zolotarev88/DI_sil3-4/Схема.docx

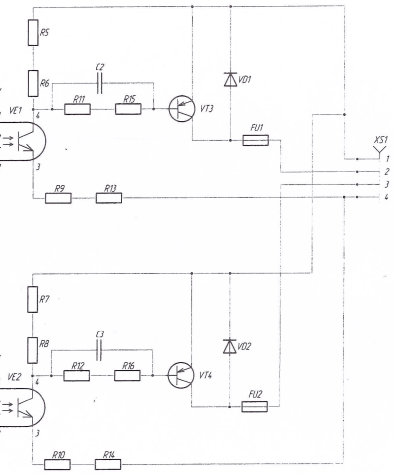
[picture p35: figure]
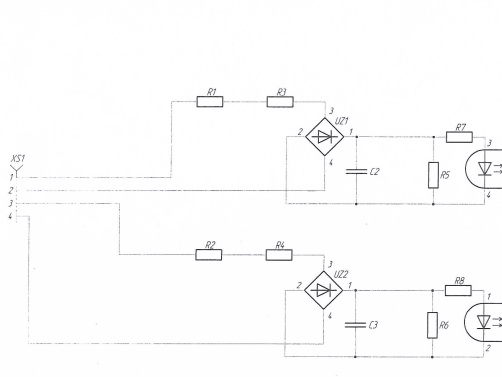
[picture p36: figure]
