zolotarev88/DI_sil3-4/Стр. МВВ.pdf

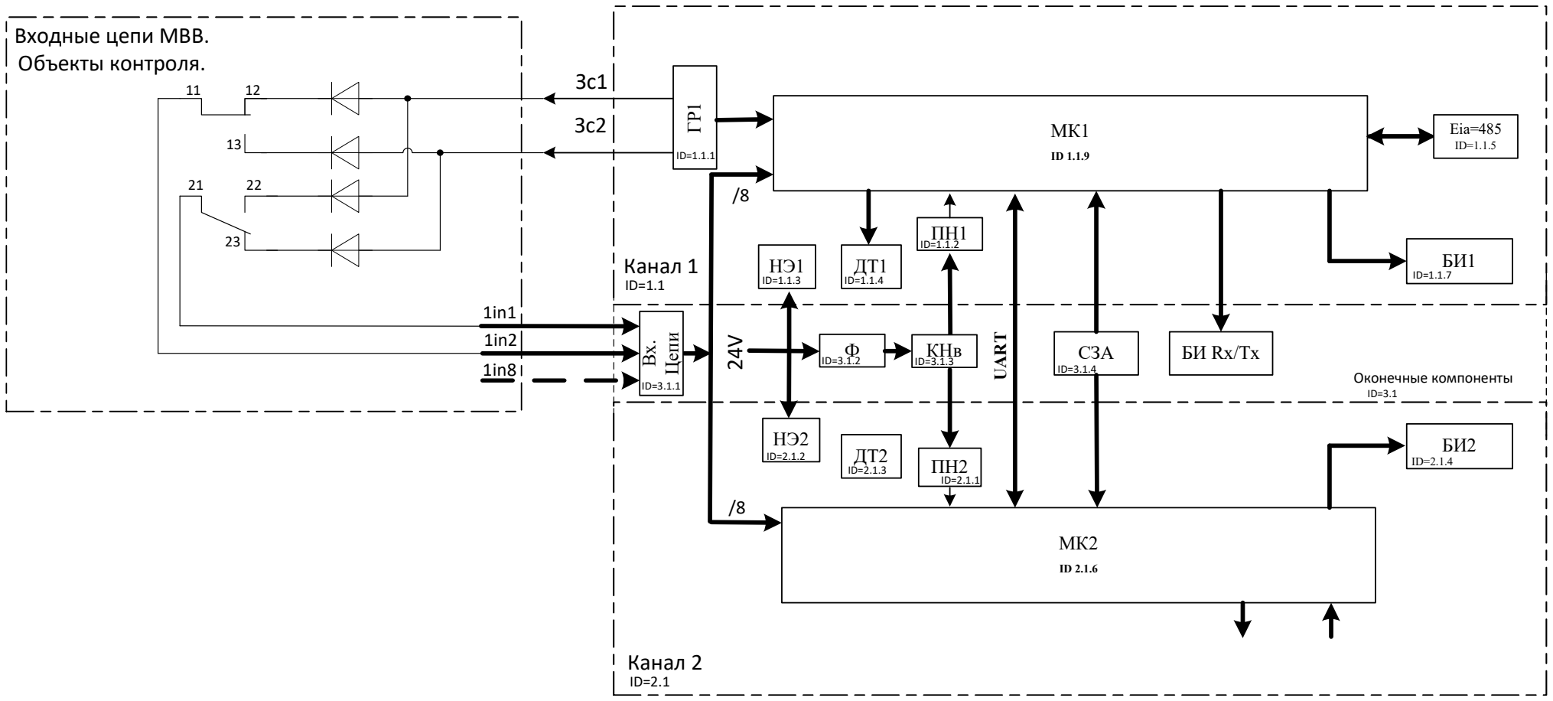
[picture p37: figure]
МК1 ID 1.1.9 UART; Входные цепи МВВ. Объекты контроля.; Канал 1; Канал 2; 22 Вх. Цепи; БИ1 ГР¹; Eia=485 ID=1.1.5; Оконечные компоненты; КНв; СЗА ID=3.1.4

НЭ1, НЭ2 - нагревательный элемент;
ДТ1, ДТ2 – датчик температуры;
ГР1 – гальваническая развязка внутренних цепей;
ГР –гальваническая развязка входных цепей;
Зс1, Зс2 – зондирующие сигналы;
(Импульсы поступают апериодически, но не реже чем 1 раз в 10 мс.)
Модуль воспринимает импульсы, формирует ответный пакет, и при поступление запроса от головного устройства, передает пакет.
ПН1 (ПН2) – преобразователь напряжения, предназначенный для электропитания МК1 (МК2), содержит элементы обеспечивающие гальваническую развязку внешних и внутренних цепей МВ;
ИВ1 – индикатор работы интерфейса RS-485 первого (второго) канала МВ в режиме приема данных;
ИИ1 – индикаторная пара работы порта RS-485 прием/передача;
Ф - Синфазный фильтр питания;
КНв – Контроль напряжения;
СЗА – Схема задания адресса;

### Рисунок Б.1 – Функциональная схема МВВ ЕРКФ.426436.001

Гр.1

ID 1.1.1

ПН1

ID 1.1.2

МК1

ID 1.1.9

НЭ1

ID 1.1.3

ДТ1

ID 1.1.4

EIA-485

ID 1.1.5

ПН2

ID 2.1.1

МК1

ID 2.1.6

НЭ1

ID 2.1.3

ДТ1

ID 2.1.4

Гр

ID 3.1.1

Ф

ID 3.1.2

КНв

ID 3.1.3

СЗА

ID 3.1.4

Канал 1.

## Канал 2

## Оконечные компоненты

Кан. 1 | Кан. 2 | Окон. Комп.

Общая.
