zolotarev88/DI_sil3-4/npcprom/WhatsApp Image 2022-07-06 at 10.55.22.jpeg

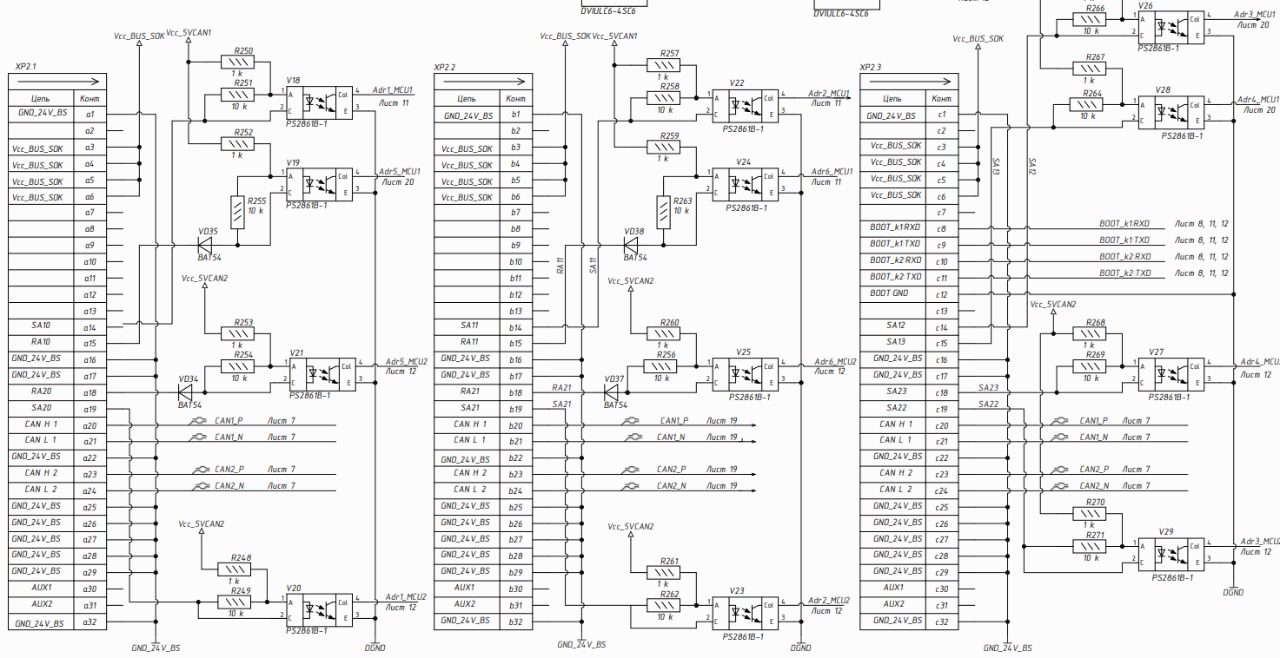
npcprom/WhatsApp Image 2022-07-06 at 10.55.22.jpeg
