zolotarev88/DI_sil3-4/npcprom/DI_перечень.xlsx

позиционное обозначение | номинал | Kommentar
C1 — С9 | 1000 пФ | CC0603KRX7R9BB102, Керамический ЧИП-конденсатор 0603 X7R 1000пФ ±10% 50В
C10 | 10 мкФ | CC1210KKX7R9BB106, Керамический ЧИП-конденсатор 1210 X7R 10мкФ ±10% 50В
C11 | 470 мкФ | SH063M0470B5S-1325, Конденсатор радиальный миниатюрный 470мкФ 63В ±20% 13*25 105°
C12 | 1 мкФ | CC0603KRX7R9BB105, Керамический ЧИП-конденсатор 0603 X7R 1мкФ ±10% 50В
C13 | 10 мкФ | CC1210KKX7R9BB106, Керамический ЧИП-конденсатор 1210 X7R 10мкФ ±10% 50В
C14, C15 | 1 нФ 2000v | CC1206KKX7RDBB102, Керамический ЧИП-конденсатор 1206 X7R 1000пФ ±10% 2000В
C16, C17 | 10 мкФ | CC1210KKX7R9BB106, Керамический ЧИП-конденсатор 1210 X7R 10мкФ ±10% 50В
C18 | 1 мкФ | CC0603KRX7R9BB105, Керамический ЧИП-конденсатор 0603 X7R 1мкФ ±10% 50В
C19, C20 | 0,1 мкФ | CC0603KRX5R9BB104, Керамический ЧИП-конденсатор 0603 X5R 0.1мкФ ±10% 50В
C21 | 1 мкФ | CC0603KRX7R9BB105, Керамический ЧИП-конденсатор 0603 X7R 1мкФ ±10% 50В
C22 | 1 нФ 2000v | CC1206KKX7RDBB102, Керамический ЧИП-конденсатор 1206 X7R 1000пФ ±10% 2000В
C23 - С25 | 0,1 мкФ | CC0603KRX5R9BB104, Керамический ЧИП-конденсатор 0603 X5R 0.1мкФ ±10% 50В
C26б C27 | 22 мкФ | CC1206KKX7R6BB226, Керамический ЧИП-конденсатор 1206 X7R 22мкФ ±10% 10В
C28 | 0,1 мкФ | CC0603KRX5R9BB104, Керамический ЧИП-конденсатор 0603 X5R 0.1мкФ ±10% 50В
C29 | 12 пФ | C0603FRNPO9BN120, Керамический ЧИП-конденсатор 0603 NP0 12пФ ±1% 50В
C30 | 0,1 мкФ | CC0603KRX5R9BB104, Керамический ЧИП-конденсатор 0603 X5R 0.1мкФ ±10% 50В
C31 | 12 пФ | C0603FRNPO9BN120, Керамический ЧИП-конденсатор 0603 NP0 12пФ ±1% 50В
C32, C33 | 0,1 мкФ | CC0603KRX5R9BB104, Керамический ЧИП-конденсатор 0603 X5R 0.1мкФ ±10% 50В
C34, C35 | 22 мкФ | CC1206KKX7R6BB226, Керамический ЧИП-конденсатор 1206 X7R 22мкФ ±10% 10В
C36 | 0,1 мкФ | CC0603KRX5R9BB104, Керамический ЧИП-конденсатор 0603 X5R 0.1мкФ ±10% 50В
C37 | 12 пФ | C0603FRNPO9BN120, Керамический ЧИП-конденсатор 0603 NP0 12пФ ±1% 50В
C38 | 0,1 мкФ | CC0603KRX5R9BB104, Керамический ЧИП-конденсатор 0603 X5R 0.1мкФ ±10% 50В
C39 | 12 пФ | C0603FRNPO9BN120, Керамический ЧИП-конденсатор 0603 NP0 12пФ ±1% 50В
C40, C41 | 0,1 мкФ | CC0603KRX5R9BB104, Керамический ЧИП-конденсатор 0603 X5R 0.1мкФ ±10% 50В
D1, D2 | STM32F103CBT6 | микроконтроллер (аналоги GD32F103CBT6, FCM32F103CBT6, APM32F103CBT6, HK32F103CBT6, RX32F103CBT7-CBT6)
DA1, DA2 | F2405S-2WR3 | 2W isolated DC-DC converter
DA3 | TD541S485H | rs-485 driver
DA4, DA5 | AMS1117-3.3 | линейный стабилизатор напряжения
DD1- DD3 | 74HC595PW,118 | сдвиговый регистр 8 бит
FU1, FU2 | 0466.125NR | 0466.125NR, FF Fuse Chip Very Fast Acting 0.125A 125V SMD
FU3 — FU5 | 60R090XPR | 60R090XPR, Самовосстанавливающийся предохранитель PTC 0.9A(hold) 1.8A(trip) 60VDC 40A 0.99W 7.2s 0.2Ohm Radial 11.2 X 3.1mm
HL1 — HL20 | LTST-C191KGKT | Светодиод smd 1,6х0,8мм/зеленый/571нм/18-71мкд/прозрачный/130°
L1, L2 | 1 мкГн | B82498B1102J, ЧИП-индуктивность на керамике 0805 1.0мкГн ±5% 250мА
L3 | B82790S0513N201 | Дроссель на тороидальном ферритовом сердечнике с секторной обмоткой для подавления асимметричной и симметричной интерференций 51uH 0.5A SMD
L4 | 22u | CDR74BNP-220MC, Силовая SMD индуктивность 22uH ±20% 1.12A 0.13Om c магнитным экраном
L5 | ACM2520-301-2P-T002 | Синфазные дроссели / фильтры 300ohms 0.35ohms 0.4A
L6, L7 | 10 мкГн | LQM18FN100M00D, Многослойнная индуктивность SMD на ферритовом сердечнике 1МГц 10мкГн ±20% 50мА 1,17Ом по постоянному току
R1 - R4 | 10 кОм | RC1206JR-0710KL, Толстопленочный ЧИП-резистор 1206 10кОм ±5% 0.25Вт -55°С...+155°С
R5 — R8 | 2 кОм | RC0603JR-072KL, Толстопленочный ЧИП-резистор 0603 2кОм ±5% 0.1Вт -55°С...+155°С
R9 — R12 | 100 кОм | RC0603JR-07100KL, Толстопленочный ЧИП-резистор 0603 100кОм ±5% 0.1Вт -55°С...+155°С
R13 — R16 | 10 кОм | RC1206JR-0710KL, Толстопленочный ЧИП-резистор 1206 10кОм ±5% 0.25Вт -55°С...+155°С
R17 — R20 | 2 кОм | RC0603JR-072KL, Толстопленочный ЧИП-резистор 0603 2кОм ±5% 0.1Вт -55°С...+155°С
R21 — R24 | 100 кОм | RC0603JR-07100KL, Толстопленочный ЧИП-резистор 0603 100кОм ±5% 0.1Вт -55°С...+155°С
R25, R26 | 330 Ом | RC0603JR-07330RL, Толстопленочный ЧИП-резистор 0603 330Ом ±5% 0.1Вт -55°С...+155°С
R27, R28 | 10 кОм | RC1206JR-0710KL, Толстопленочный ЧИП-резистор 1206 10кОм ±5% 0.25Вт -55°С...+155°С
R29, R30 | 100 кОм | RC0603JR-07100KL, Толстопленочный ЧИП-резистор 0603 100кОм ±5% 0.1Вт -55°С...+155°С
R31, 32 | 330 Ом | RC0603JR-07330RL, Толстопленочный ЧИП-резистор 0603 330Ом ±5% 0.1Вт -55°С...+155°С
R33, R34 | 2 кОм | RC1206JR-072KL, Толстопленочный ЧИП-резистор 1206 2кОм ±5% 0.25Вт -55°С...+155°С
R35, R36 | 100 кОм | RC0603JR-07100KL, Толстопленочный ЧИП-резистор 0603 100кОм ±5% 0.1Вт -55°С...+155°С
R37 | 8.2 кОм | RC0603JR-078K2L, Толстопленочный ЧИП-резистор 0603 8.2кОм ±5% 0.1Вт -55°С...+155°С
R38 — R40 | 10 кОм | RC1206JR-0710KL, Толстопленочный ЧИП-резистор 1206 10кОм ±5% 0.25Вт -55°С...+155°С
R41 | 100 кОм | RC0603JR-07100KL, Толстопленочный ЧИП-резистор 0603 100кОм ±5% 0.1Вт -55°С...+155°С
R42 | 10 кОм | RC1206JR-0710KL, Толстопленочный ЧИП-резистор 1206 10кОм ±5% 0.25Вт -55°С...+155°С
R43 | 100 кОм | RC0603JR-07100KL, Толстопленочный ЧИП-резистор 0603 100кОм ±5% 0.1Вт -55°С...+155°С
R44 | 8.2 кОм | RC0603JR-078K2L, Толстопленочный ЧИП-резистор 0603 8.2кОм ±5% 0.1Вт -55°С...+155°С
R45 | 330 Ом | RC0603JR-07330RL, Толстопленочный ЧИП-резистор 0603 330Ом ±5% 0.1Вт -55°С...+155°С
R46 — R47 | 100 кОм | RC0603JR-07100KL, Толстопленочный ЧИП-резистор 0603 100кОм ±5% 0.1Вт -55°С...+155°С
R48 | 10 кОм | RC1206JR-0710KL, Толстопленочный ЧИП-резистор 1206 10кОм ±5% 0.25Вт -55°С...+155°С
R49 | 15k | RC0603JR-0715KL, Толстопленочный ЧИП-резистор 0603 15кОм ±5% 0.1Вт -55°С...+155°С
R50 | 10 кОм | RC1206JR-0710KL, Толстопленочный ЧИП-резистор 1206 10кОм ±5% 0.25Вт -55°С...+155°С
R51 | 4,7 Ом | RC1206JR-074R7L, Толстопленочный ЧИП-резистор 1206 4.7Ом ±5% 0.25Вт -55°С...+155°С
R52 | 100 кОм | RC0603JR-07100KL, Толстопленочный ЧИП-резистор 0603 100кОм ±5% 0.1Вт -55°С...+155°С
R53 | 330 Ом | RC0603JR-07330RL, Толстопленочный ЧИП-резистор 0603 330Ом ±5% 0.1Вт -55°С...+155°С
R54 | 100 кОм | RC0603JR-07100KL, Толстопленочный ЧИП-резистор 0603 100кОм ±5% 0.1Вт -55°С...+155°С
R55 | 10 кОм | RC1206JR-0710KL, Толстопленочный ЧИП-резистор 1206 10кОм ±5% 0.25Вт -55°С...+155°С
R56 | 4,7 Ом | RC1206JR-074R7L, Толстопленочный ЧИП-резистор 1206 4.7Ом ±5% 0.25Вт -55°С...+155°С
R57 | 1 МОм | RC1206JR-071ML, Толстопленочный ЧИП-резистор 1206 1МОм ±5% 0.25Вт -55°С...+155°С
R58 | 5,1 Ом | RC0805JR-075R1L, Толстопленочный ЧИП-резистор 0805 5.1Ом ±5% 0.125Вт -55°С...+155°С
R60 — R79 | 330 Ом | RC0603JR-07330RL, Толстопленочный ЧИП-резистор 0603 330Ом ±5% 0.1Вт -55°С...+155°С
R80, R81 | 100 кОм | RC0603JR-07100KL, Толстопленочный ЧИП-резистор 0603 100кОм ±5% 0.1Вт -55°С...+155°С
U1 — U18 | LTV-356T-B | LTV-356T-B, Оптопара транзисторная одноканальная 3.75кВ /80В 0.05A Кус=130...260% 0.17Вт -30...+110°C
VD1 — VD14 | BAS70J | Диод Шоттки 70В 50мА
VD15, VD16 | PESD24VS1UB,115 | TVS диод защитный 24В_пиковое_рабочее 70В_ограничение SOD523
VD17, VD18 | BAS70J | Диод Шоттки 70В 50мА
VD19 | 10BQ100 | 10BQ100, Диод Шоттки 100В 1А
VD20 | s20k30 | B72220S1300K102, Варистор 30Vac/34Vdc, 2000A, 22V(1mA), радиальные выводы, россыпь, автомобильная серия
VD21, VD22 | TL431 | TL431QDBZR,215, Стабилизатор напряжения линейный регулируемый +2,495...+36В 0.1A ±2% -40...+125°C Rвых=0,2Ом
VD23 | 10BQ100 | 10BQ100, Диод Шоттки 100В 1А
VD24 | s20k30 | B72220S1300K102, Варистор 30Vac/34Vdc, 2000A, 22V(1mA), радиальные выводы, россыпь, автомобильная серия
VD25 | TL431 | TL431QDBZR,215, Стабилизатор напряжения линейный регулируемый +2,495...+36В 0.1A ±2% -40...+125°C Rвых=0,2Ом
VD26 | 10BQ100 | 10BQ100, Диод Шоттки 100В 1А
VD27 | s20k30 | B72220S1300K102, Варистор 30Vac/34Vdc, 2000A, 22V(1mA), радиальные выводы, россыпь, автомобильная серия
VD28 | BAS70J | Диод Шоттки 70В 50мА
VD29 | SMBJ8.5CA | SMBJ8.5CA-TR, Ограничитель напряжения Р=600Вт U=8.5В двунаправленный
VD30 | BAS70J | Диод Шоттки 70В 50мА
VT1, VT2 | BCX56,115 | Биполярный транзистор, NPN, 80 В, 1 А, 1.25 Вт
VT3 | 2n7002 | 2N7002K, Транзистор полевой N-канальный 60В 200мА, 0.2Вт
VT4 | IRFL9110TRPBF | IRFL9110TRPBF, Транзистор полевой P-канальный 100В 1.1А 3.1Вт
VT5 | BC846 | BC846BLT1G, Биполярный транзистор, NPN, 65 В, 0.1 А, 0.225 Вт
VT6 | MJD112G | MJD112G, Биполярный транзистор, NPN, составной (Darlington), 100 В, 2 А, 20Вт
VT7 | BC846 | BC846BLT1G, Биполярный транзистор, NPN, 65 В, 0.1 А, 0.225 Вт
VT8 | MJD112G | MJD112G, Биполярный транзистор, NPN, составной (Darlington), 100 В, 2 А, 20Вт
X1 | разъем провод -плата | 15EDGRC-3.81-12P-14-00AH, Разъемный клеммный блок на плату, 12 контактов + 15EDGK-3.81-12P-14-00AH, Разъемный клеммный блок, 12 контактов.
X2 |  | вариант RJ11 (4p4c)
X3 |  | вариант RJ11 (4p4c)
X4 | разъем провод -плата | 2EDGRC-5.0-03P-14-00AH, Разъемный клеммный блок на плату, 3 контакта + 2EDGK-5.0-03P-14-00AH, Разъемный клеммный блок, 3 контакта.
X5 | разъем провод -плата | 15EDGRC-3.5-03P-14-00AH, Разъемный клеммный блок на плату, 3 контакта. + 15EDGK-3.5-03P-14-00AH, Разъемный клеммный блок, 3 контакта.
X6 | разъем шлейфа | 4-1734839-0, FFC / FPC разъем, 0.5 мм, 40 контакт(-ов), Гнездо, Поверхностный Монтаж, Верх
X7 | pls40 | 2 контакта
X8 |  | 3 контакта
X9 |  | 4 контакта
X10 |  | 2 контакта
X11 |  | 3 контакта
X12 |  | 4 контакта
X13 | разъем шлейфа | 4-1734839-0, FFC / FPC разъем, 0.5 мм, 40 контакт(-ов), Гнездо, Поверхностный Монтаж, Верх
ZQ1, ZQ2 | WTL3M85263FO | WTL3M85263FO, Кварцевый резонатор, корпус SMD, 16.0МГц, -40…+85°С 2,5*3,2
