zolotarev88/DI_sil3-4/npcprom/Reliability MVV.xlsx

Sheet: Вх. цепь 1-8
Поз. Обозначение. | Наименование. | Кол-во | Примечание | T, °C | CL % | MTTF | FIT | Источник. | R53 | 0,025*10^-9
С1-С4; С13-С16; | 0603 0,01 мкФ 50 В. ±5 % | 8 |  | 25 |  |  | 0.58 | IEC TR 62380 | XS1 | 0,053*10^-6
С5-С12; С17-С24; | Чип 0402 220 пФ 50 В ±5 % | 16 |  | 25 |  |  | 0.58 | IEC TR 62380 | XS2 | 0,037*10^-6
R1-R4; R25-RR28; | Чип резистор 2512 1,5 кОм 1,0 ±5 % | 8 |  | 25 |  |  | 0.26 | IEC TR 62380 | XS3 | 0,037*10^-6
R5-R8; R29-R32; | Чип-резистор 0603 200 Ом 0,1 ±5 % | 8 |  | 25 |  |  | 0.3 | IEC TR 62380 | C37 | 0,0001*10^-6
R9-R16; R33-R40; | Чип-резистор 0402 200 Ом 0,063 ±5 % | 16 |  | 25 |  |  | 0.3 | IEC TR 62380
R17-R24; R41-48; | Чип-резистор 0402 10 кОм 0,063 ±1 % | 16 |  | 25 |  |  | 0.3 | IEC TR 62380
U1-U8 | Оптрон PS2801-1-F3-A | 8 |  | 25 |  |  | 15 | IEC TR 62380
VD1-VD8 | Диод 1N4448 | 8 |  | 25 |  |  | 5.57 | IEC TR 62380 | FR (Failure rate), то лямбду надо умножить на 10^(-9)
 |  |  |  |  |  |  |  |  | FIT (Failure In Time), то это просто лямбда
 |  |  |  |  |  |  |  |  | MTBF (Mean Time Between Failures), то 1/(лямбда * 10^(-9) )

Sheet: Цепи питания.
Поз. Обозначение | Наименование | Кол-во. | Примечание | T, °C | CL % | MTBF | FIT | Источник.
С25 | Чип 0603 0,01 мкФ 50 В ±5 % | 1 |  | 25 |  |  | 0.58 | IEC TR 62380
С26, С27 | Чип 1206 10 мкФ 50 В ±10 % | 2 |  | 25 |  |  | 0.58 | IEC TR 62380
С28 | Чип 0402 220 пФ 50 В ±10 % | 1 |  | 25 |  |  | 0.58 | IEC TR 62380
С29 | Чип 0603 0,1 мкФ 50 В ±5 % | 1 |  | 25 |  |  | 0.58 | IEC TR 62380
С30; С32 | Конденсатор электролитический 10х12 220 мкФ 63 В | 2 |  | 25
С31 | Чип 1206 10 мкФ 50 В ±10 % | 1 |  | 25 |  |  | 0.58 | IEC TR 62380
С33, С34 | Чип 0402 0,1 мкФ | 2 |  | 25 |  |  | 0.58 | IEC TR 62380
С35, С36 | Чип 0402 10 мкФ | 2 |  | 25 |  |  | 0.58 | IEC TR 62380
R49 | Чип-резистор 2512 1,5 кОм 1,0 ±5 % | 1 |  | 25 |  |  | 0.3 | IEC TR 62380
R50 | Чип-резистор 0603 200 Ом 0,1 ±5 % | 1 |  | 25 |  |  | 0.36 | IEC TR 62380
R51 | Чип-резистор 0402 200 Ом 0,063 ±1 % | 1 |  | 25 |  |  | 0.3 | IEC TR 62380
R52 | Чип-резистор 0402 10 кОм 0,063 ±1 % | 1 |  | 25 |  |  | 0.3 | IEC TR 62380
DA1, DA2 | TMR2411 | 2 |  | 25 |  | 4700000 |  | thm6wi-datasheet
DA3,DA4 | LD1117DT33TR | 2 |  | 25
U9 | Оптрон PS2801-1-F3-A | 1 |  | 25 |  |  | 15 | IEC TR 62380
VD9; VD11 | Диод 1N4007W | 2 |  | 25
VD10 | Диод PTVS33VS1UTR | 1 |  | 25 |  |  | 3.88 | IEC TR 62380
L1 | SRF0905-202Y | 1 |  | 25
L2 | B82477G4 22 мкГн | 1 |  | 25 |  |  | 0.15 | IEC TR 62380
FU1 | 0.5А | 1 |  | 25 |  |  | 10 | IEC TR 62380

Sheet: МК1
Поз. Обозначение. | Нименование. | Кол-во | Примечание. | T, °C | CL % | MTTF | FIT | Источник.
С37 | Чип 1206 47 мкФ 25 В ±20 % | 1 |  | 25 |  |  | 0.58 | IEC TR 62380
С38 | Чип 0402 0,1 мкФ 50 В ±10% | 1 |  | 25 |  |  | 0.58 | IEC TR 62380
С39, С40. | Чип 0402 10 пФ 50 В ±5 % | 2 |  | 25 |  |  | 0.58 | IEC TR 62380
C41 | Чип 0402 0,1 мкФ 50 В ±10 % | 1 |  | 25 |  |  | 0.58 | IEC TR 62380
C42, C43 | Чип 0402 10 пФ 50 В ±5 % | 2 |  | 25 |  |  | 0.58 | IEC TR 62380
C44, C45, C46, C47, C48 | Чип 0402 0,1 мкФ 50 В ±10 % | 5 |  | 25 |  |  | 0.58 | IEC TR 62380
DD1 | STM32L073CBT6 | 1 |  | 55 |  |  | 2.2 | STM32_Reliability.pdf
L3 | B82477G4 22 мкГн | 1 |  | 25 |  |  | 0.15 | IEC TR 62380
R53 | Чип-резистор 0402 100 кОм 0,063 ±1 % | 1 |  | 25 |  |  | 0.335 | IEC TR 62380
XS1 | PLS-4, Вилка штыревая 2,54 мм | 1 |  | 25 |  |  | 2.8 | IEC TR 62380
XS2, XS3 | PLS-2, Вилка штыревая 2,54 мм | 2 |  | 25 |  |  | 2.8 | IEC TR 62380
ZL1 | ABS25-32.768KHZ-6-1-T | 1 |  | 25 |  |  | 16.86 | IEC TR 62380
ZL2 | ABM8-24.000MHZ-B2-T | 1 |  | 25 |  |  | 16.86 | IEC TR 62380

Sheet: МК2
Поз. Обозначение. | Нименование. | Кол-во | Примечание. | T, °C | CL % | MTTF | FIT | Источник.
C49 | Чип 1206 47 мкФ 25 В ±20 % | 1 |  | 25 |  |  | 0.58 | IEC TR 62380
C50, C53, C56-C60 | Чип 0402 0,1 мкФ 50 В ±10% | 7 |  | 25 |  |  | 0.58 | IEC TR 62380
C51, C52 | Чип 0402 10 пФ 50 В ±5 % | 2 |  | 25 |  |  | 0.58 | IEC TR 62380
DD2 | STM32L073CBT6 | 1 |  | 55 |  |  | 2.2 | STM32_Reliability.pdf
L4 | B82477G4 22 мкГн | 1 |  | 25 |  |  | 0.15 | IEC TR 62380
R54 | 0402 100 кОм 0,063 ±1 % | 1 |  | 25 |  |  | 0.335 | IEC TR 62380
XS4 | PLS-4, Вилка штыревая 2,54 мм | 1 |  | 25 |  |  | 2.8 | IEC TR 62380
XS5, XS6 | PLS-2, Вилка штыревая 2,54 мм | 2 |  | 25 |  |  | 2.8 | IEC TR 62380
ZL3 | ABS25-32.768KHZ-6-1-T | 1 |  | 25 |  |  | 16.86 | IEC TR 62380
ZL4 | ABM8-24.000MHZ-B2-T | 1 |  | 25 |  |  | 16.86 | IEC TR 62380

Sheet: RS485
Поз. Обозначение. | Нименование. | Кол-во | Примечание. | T, °C | CL % | MTTF | FIT | Источник.
C61, C63, C65 | NFM21CC102R1H3 | 3 |  | 25 |  |  | 0.017 | https://www.murata.com/en-eu/products/capacitor/siliconcapacitors/overview/passivecomponentnetwork/reliability
C67, C68, C77, C78 | Чип 0402 0,1 мкФ 50 В ±10 % | 4 |  | 25 |  |  | 0.58 | IEC TR 62380
C71, C81 | Чип 0402 0,01 мкФ 50 В ±10 % | 2 |  | 25 |  |  | 0.58 | IEC TR 62380
С72, C82 | Чип 0805 10 мкФ 16 В ±10 % | 2 |  | 25 |  |  | 0.58 | IEC TR 62380
C75 | Чип 1206 220 пФ 2000 В ±5 % | 1 |  | 25 |  |  | 0.58 | IEC TR 62380
С83 | Чип 1206 1000 пФ 2000 В ±10 % | 1 |  | 25 |  |  | 0.58 | IEC TR 62380
D5 | TDH541S485H | 1 |  | 25
R59 | Чип-резистор 0805 1 МОм 0,125 ±1% | 1 |  | 25 |  |  | 0.26 | IEC TR 62380
VD14 | Диод SM712 | 1 |  | 25 |  |  | 0.0016 | https://www.semtech.com/quality/reliability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 | 8,41 fits | https://www.onsemi.com/PowerSolutions/reliability.do?device=MOCD217M
 |  |  |  |  |  |  |  |  | 0,017 fit

Sheet: Лист3
Поз. Обозначение. | Нименование. | Кол-во | Примечание. | T, °C | CL % | MTTF | FIT | Источник.

Sheet: Лист4
Поз. Обозначение. | Нименование. | Кол-во | Примечание. | T, °C | CL % | MTTF | FIT | Источник.
