zolotarev88/DI_sil3-4/connectors/pxc_2203902_01_ICC25-H-4L5-0-7035_3D/ICC25-H-4L5.0__01080961_H.Select.stp

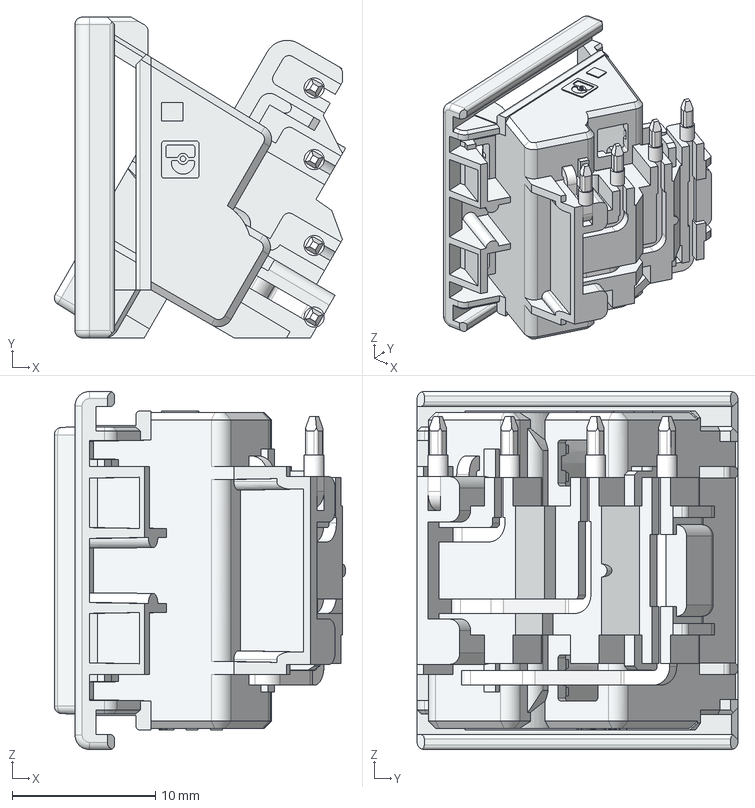
[picture p39: CAD file, 2020-03-10]
connectors/pxc_2203902_01_ICC25-H-4L5-0-7035_3D/ICC25-H-4L5.0__01080961_H.Select.stp
20.3 x 22.4 x 25.0 mm
