zolotarev88/DI_sil3-4/connectors/pxc_2203903_01_ICC25-H-4R5-0-7035_3D/PCB-FRAGMENT_ICC25-H_4R5.0_01087108.stp

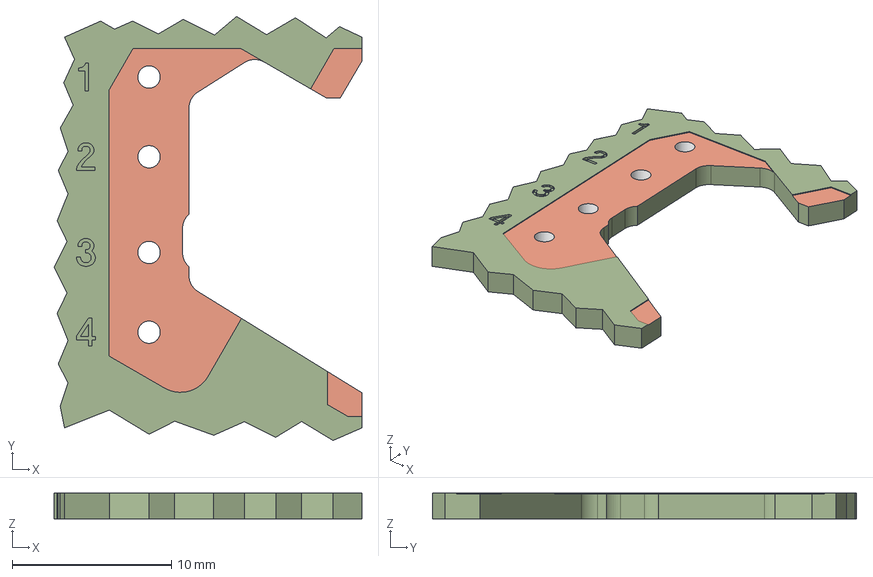
[picture p40: CAD file, 2020-03-10]
connectors/pxc_2203903_01_ICC25-H-4R5-0-7035_3D/PCB-FRAGMENT_ICC25-H_4R5.0_01087108.stp
19.3 x 26.6 x 1.60 mm
