zolotarev88/DI_sil3-4/DI/component/98658887-19-usb_a-usb_a-lp-c/usb_a-usb_a-lp-c.stp

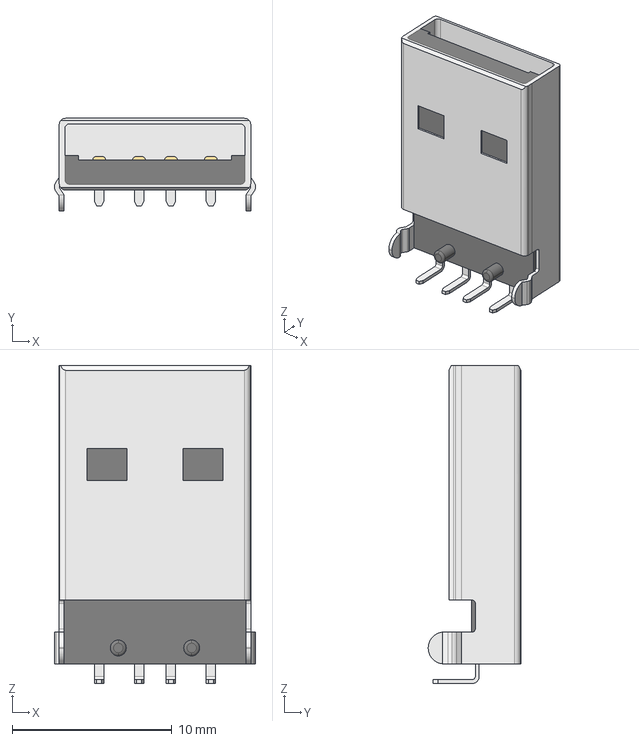
[picture p41: CAD file, 2020-03-05]
DI/component/98658887-19-usb_a-usb_a-lp-c/usb_a-usb_a-lp-c.stp
12.6 x 5.80 x 19.9 mm
