zolotarev88/DI_sil3-4/DI/component/User Library-AM1D-0505S.step

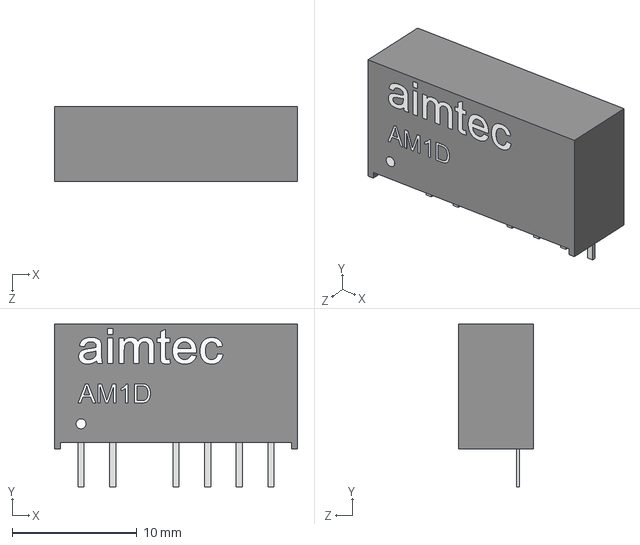
[picture p42: CAD file, 2020-03-05]
DI/component/User Library-AM1D-0505S.step
19.5 x 13.1 x 6.01 mm
