zolotarev88/DI_sil3-4/DI/component/User Library-SOIC127P610X343-8N/User Library-SOIC127P610X343-8N.STEP

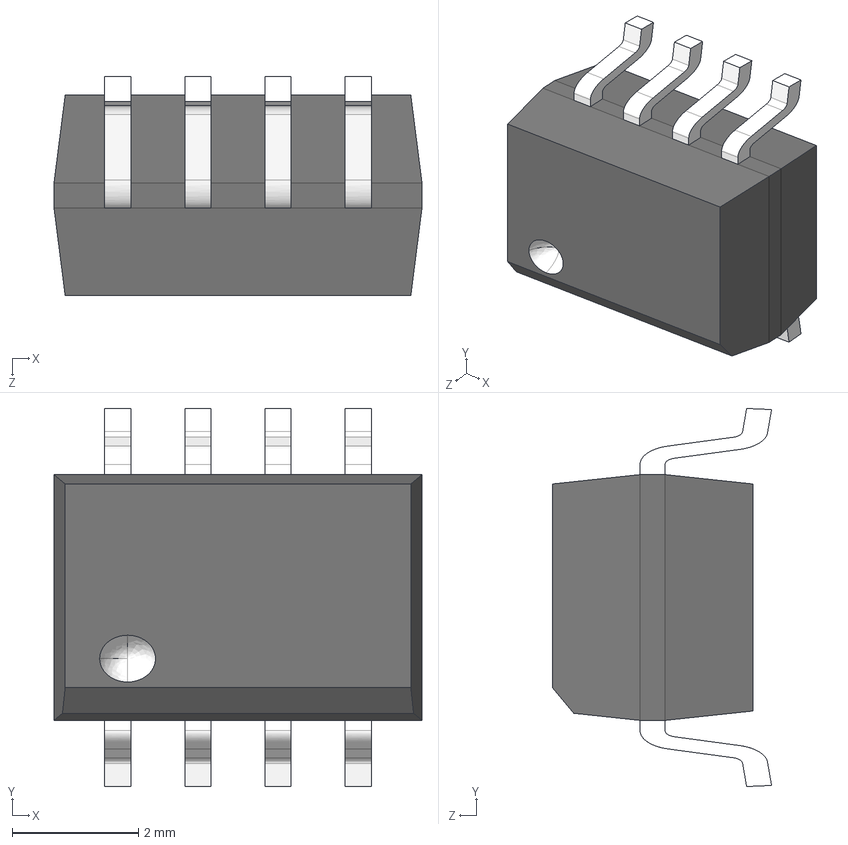
[picture p43: CAD file, 2020-03-05]
DI/component/User Library-SOIC127P610X343-8N/User Library-SOIC127P610X343-8N.STEP
5.84 x 6.00 x 3.48 mm
