zolotarev88/DI_sil3-4/connectors/pxc_2203903_01_ICC25-H-4R5-0-7035_3D/pxc_2203903_01_ICC25-H-4R5-0-7035_3D.stp

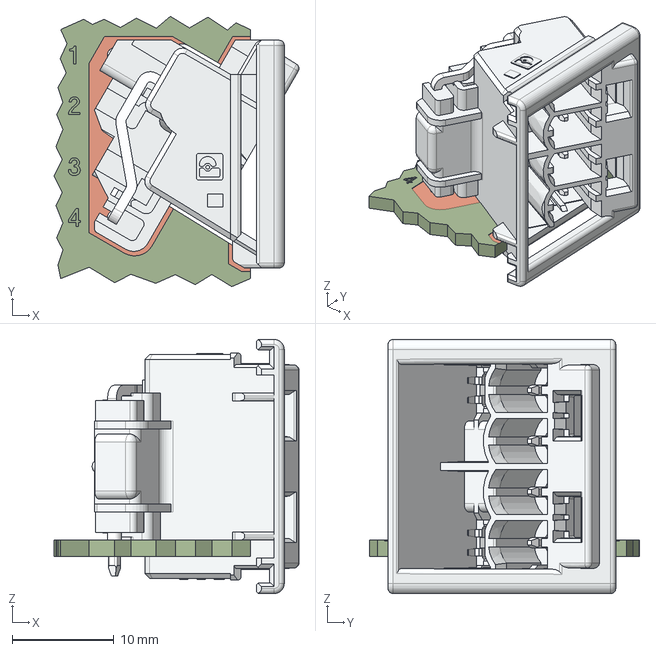
[picture p44: CAD file, 2020-03-10]
connectors/pxc_2203903_01_ICC25-H-4R5-0-7035_3D/pxc_2203903_01_ICC25-H-4R5-0-7035_3D.stp
24.1 x 26.6 x 25.0 mm
ICC25-H-4R5.0__01083879_H.Select
PCB-FRAGMENT_ICC25-H_4R5.0_01087108
