zolotarev88/DI_sil3-4/DI/component/User Library-SOD-323F.STEP

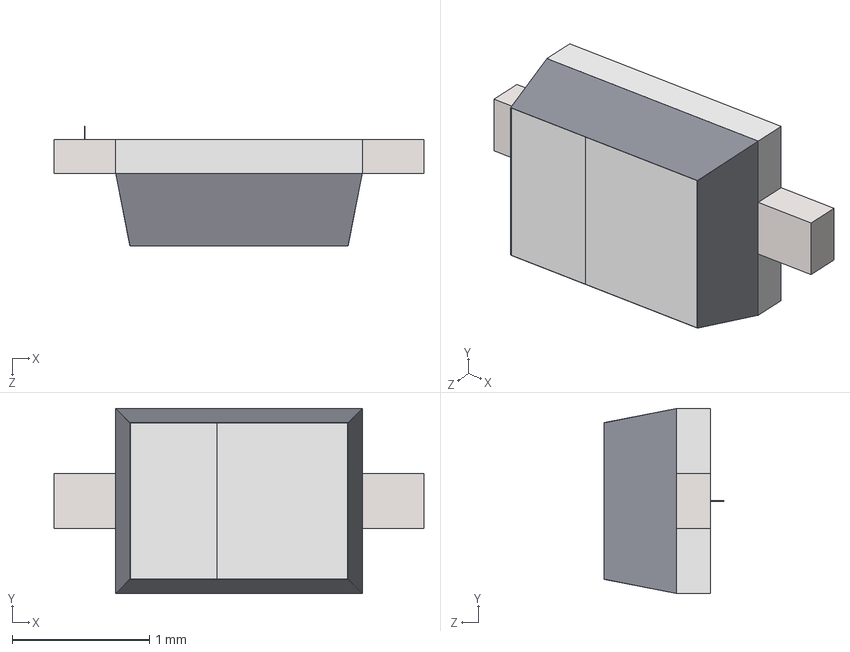
[picture p45: CAD file, 2020-03-05]
DI/component/User Library-SOD-323F.STEP
2.70 x 1.35 x 0.875 mm
Extruded8 x 2
Extruded6
Extruded7
Extruded9 x 2
Board4 x 2
Extruded11
Board3 x 2
Extruded10 x 2
Board5
