zolotarev88/DI_sil3-4/DI/component/User Library-USB 2_0 Type A Male v2.step

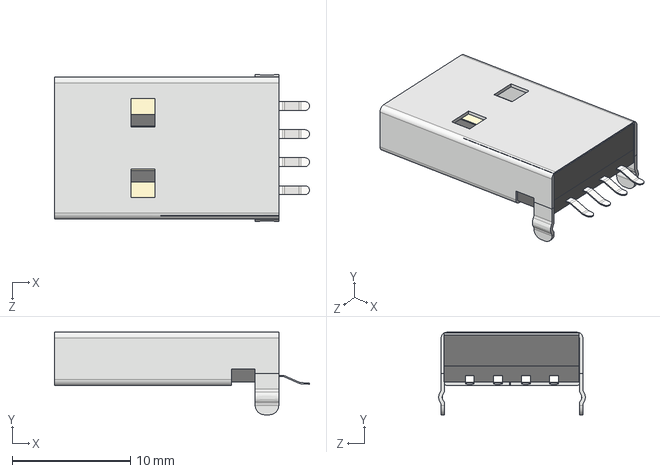
[picture p46: CAD file, 2020-03-05]
DI/component/User Library-USB 2_0 Type A Male v2.step
21.6 x 7.00 x 12.4 mm
