zolotarev88/DI_sil3-4/(list of files, cad)

Other CAD files:
connectors/pxc_2203902_01_ICC25-H-4L5-0-7035_3D/PCB-FRAGMENT_ICC25-H_4L5.0_01084043.stp
connectors/pxc_2203902_01_ICC25-H-4L5-0-7035_3D/pxc_2203902_01_ICC25-H-4L5-0-7035_3D.stp
connectors/pxc_2203903_01_ICC25-H-4R5-0-7035_3D/ICC25-H-4R5.0__01083879_H.Select.stp
