zolotarev88/DI_sil3-4/МВВ_Э3.pdf

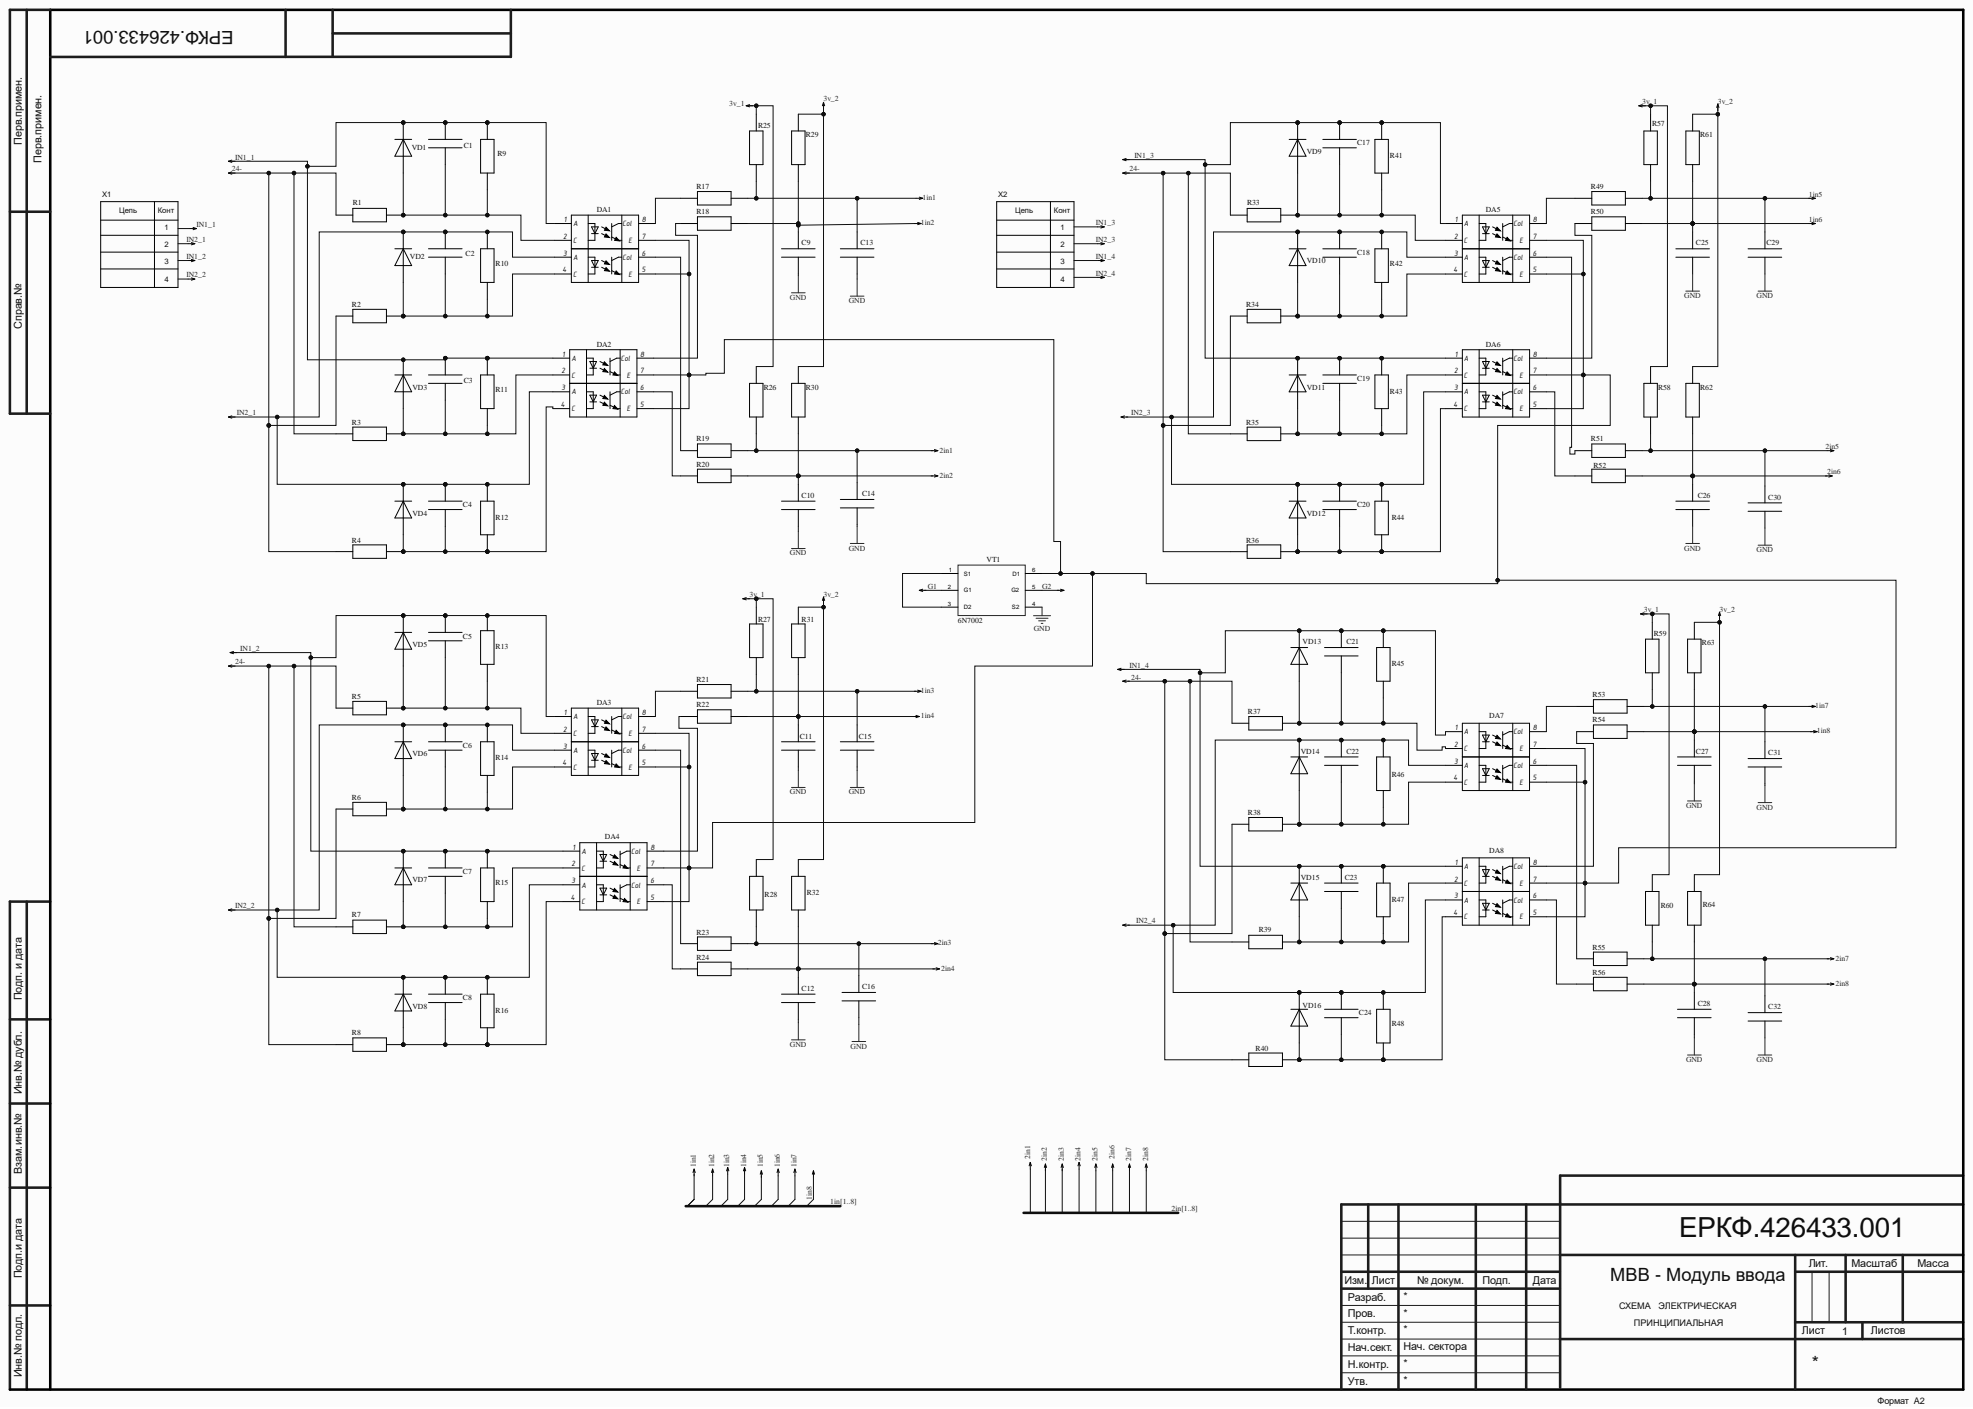
[picture p47: page 1]

A C | Col E

Инв.№ подл. Подп.и дата Взам.инв.№ Инв.№ дубл. Подп. и дата

ЕРК

МВВ -Модуль ввода СХЕМ А ЭЛЕК ТРИЧЕСКАЯ ПРИНЦИПИАЛЬНАЯ | Лит . | Масш таб | Масса

Из м . | Лист | № докум . | Подп . | Да т а
Т. конт р . | ***** | | | | Лист | о в
Разра б .
Пров .

Н а ч .се к т. | Н а ч . се к тора | | | | *
Н . конт р .
Ут в .

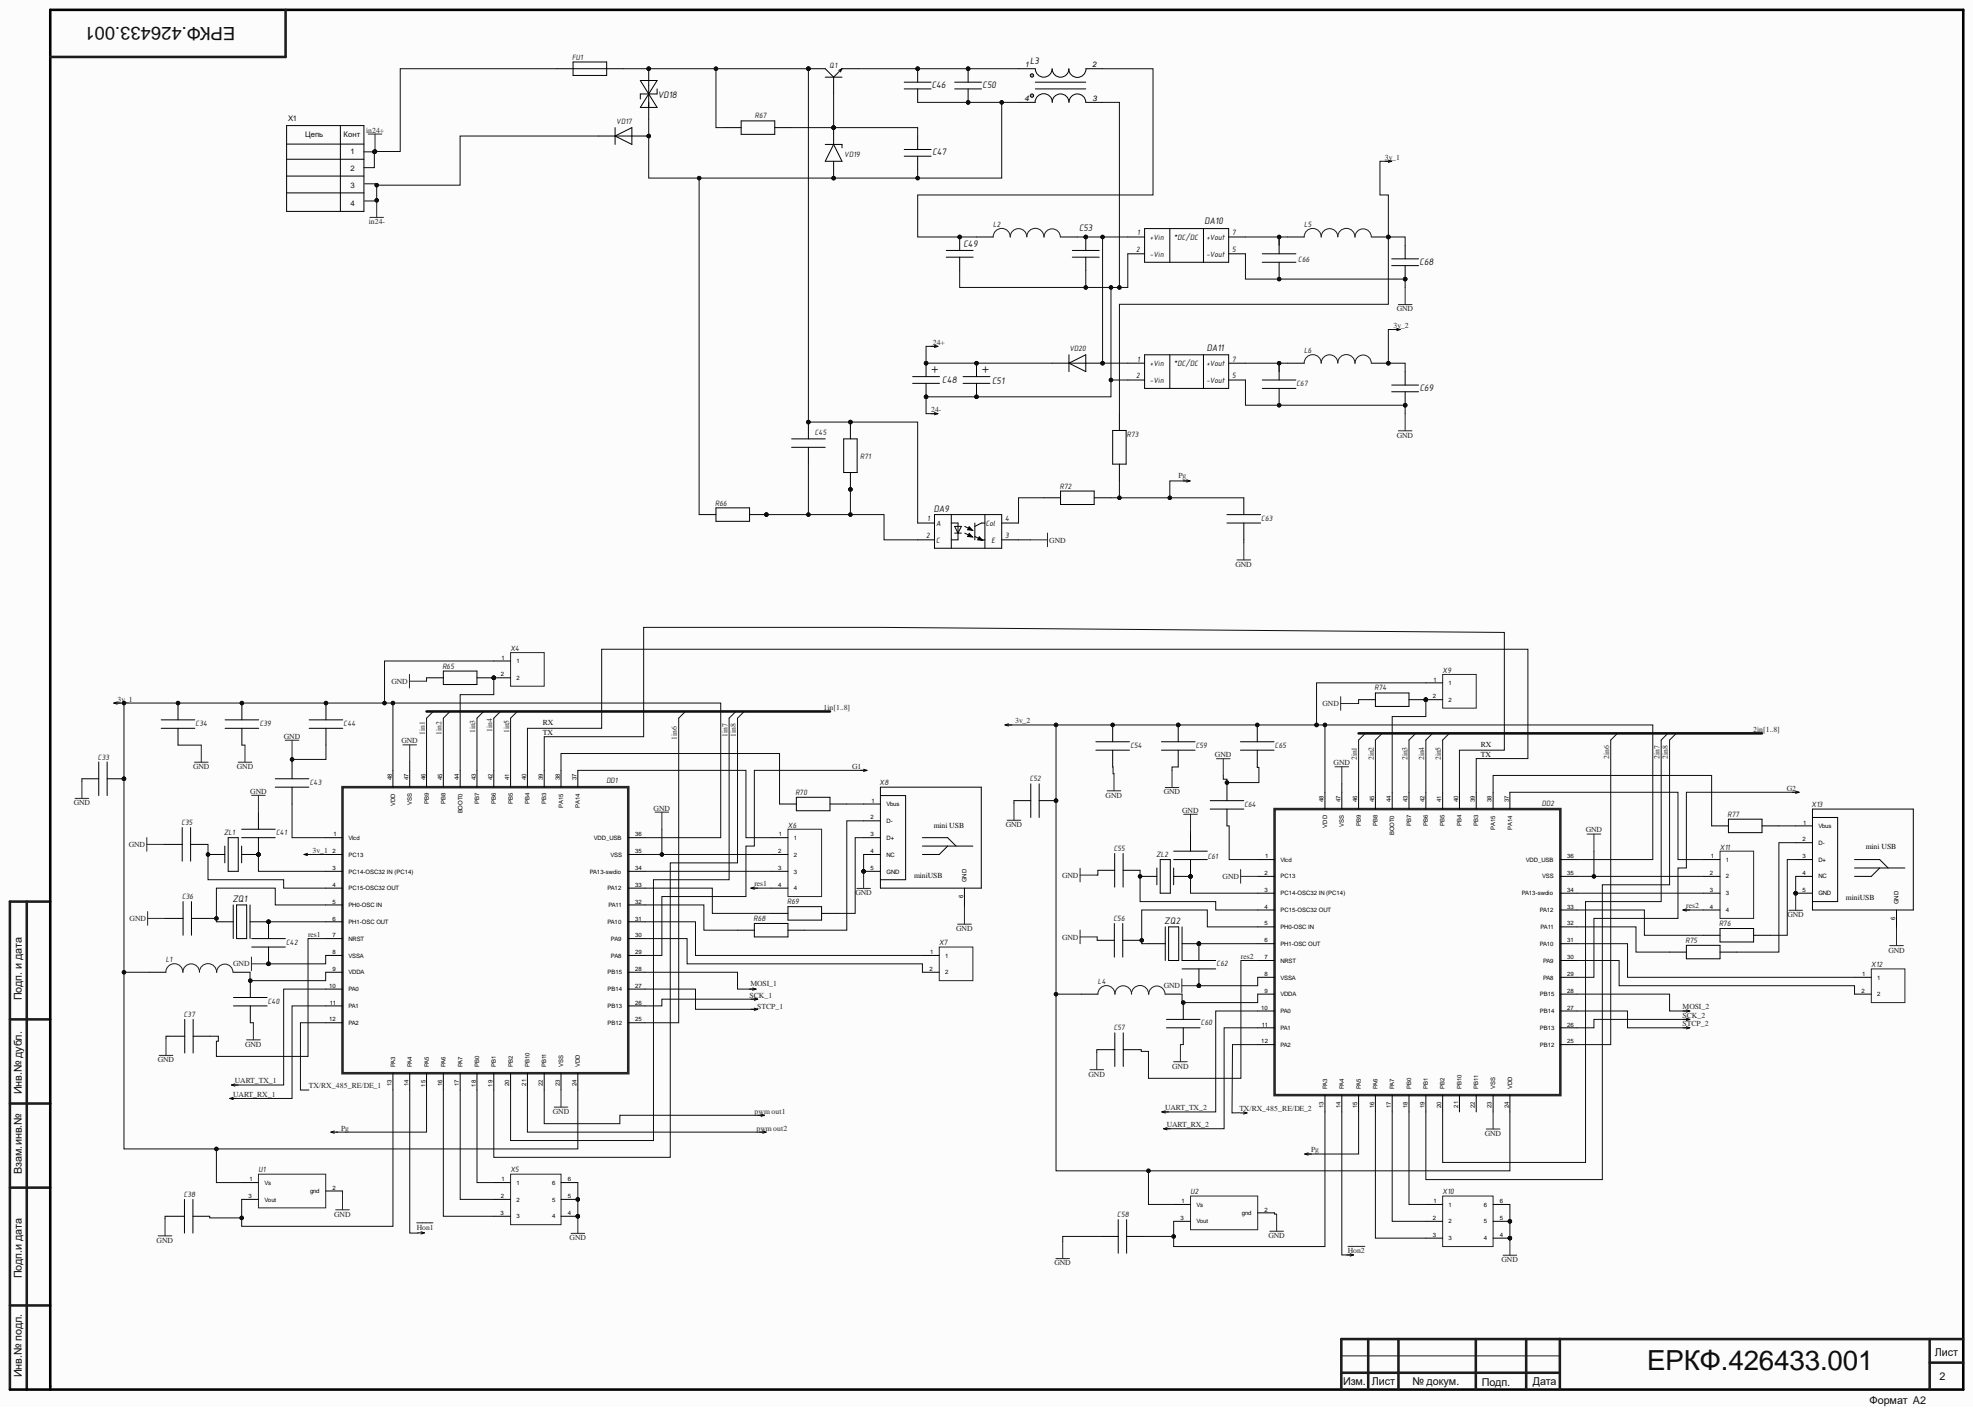
[picture p48: page 2]

Цепь | Конт

+Vin 1 | +Vout | 7 *DC/DC

+Vin 1 | +Vout -Vout | 7 *DC/DC 5 -Vin 2

GND | D- 2

Vlcd 1

л. Подп.и дата Взам.инв.№

ЕРКФ.426433.001

Изм. | Лист | № докум. | Подп. | Дата

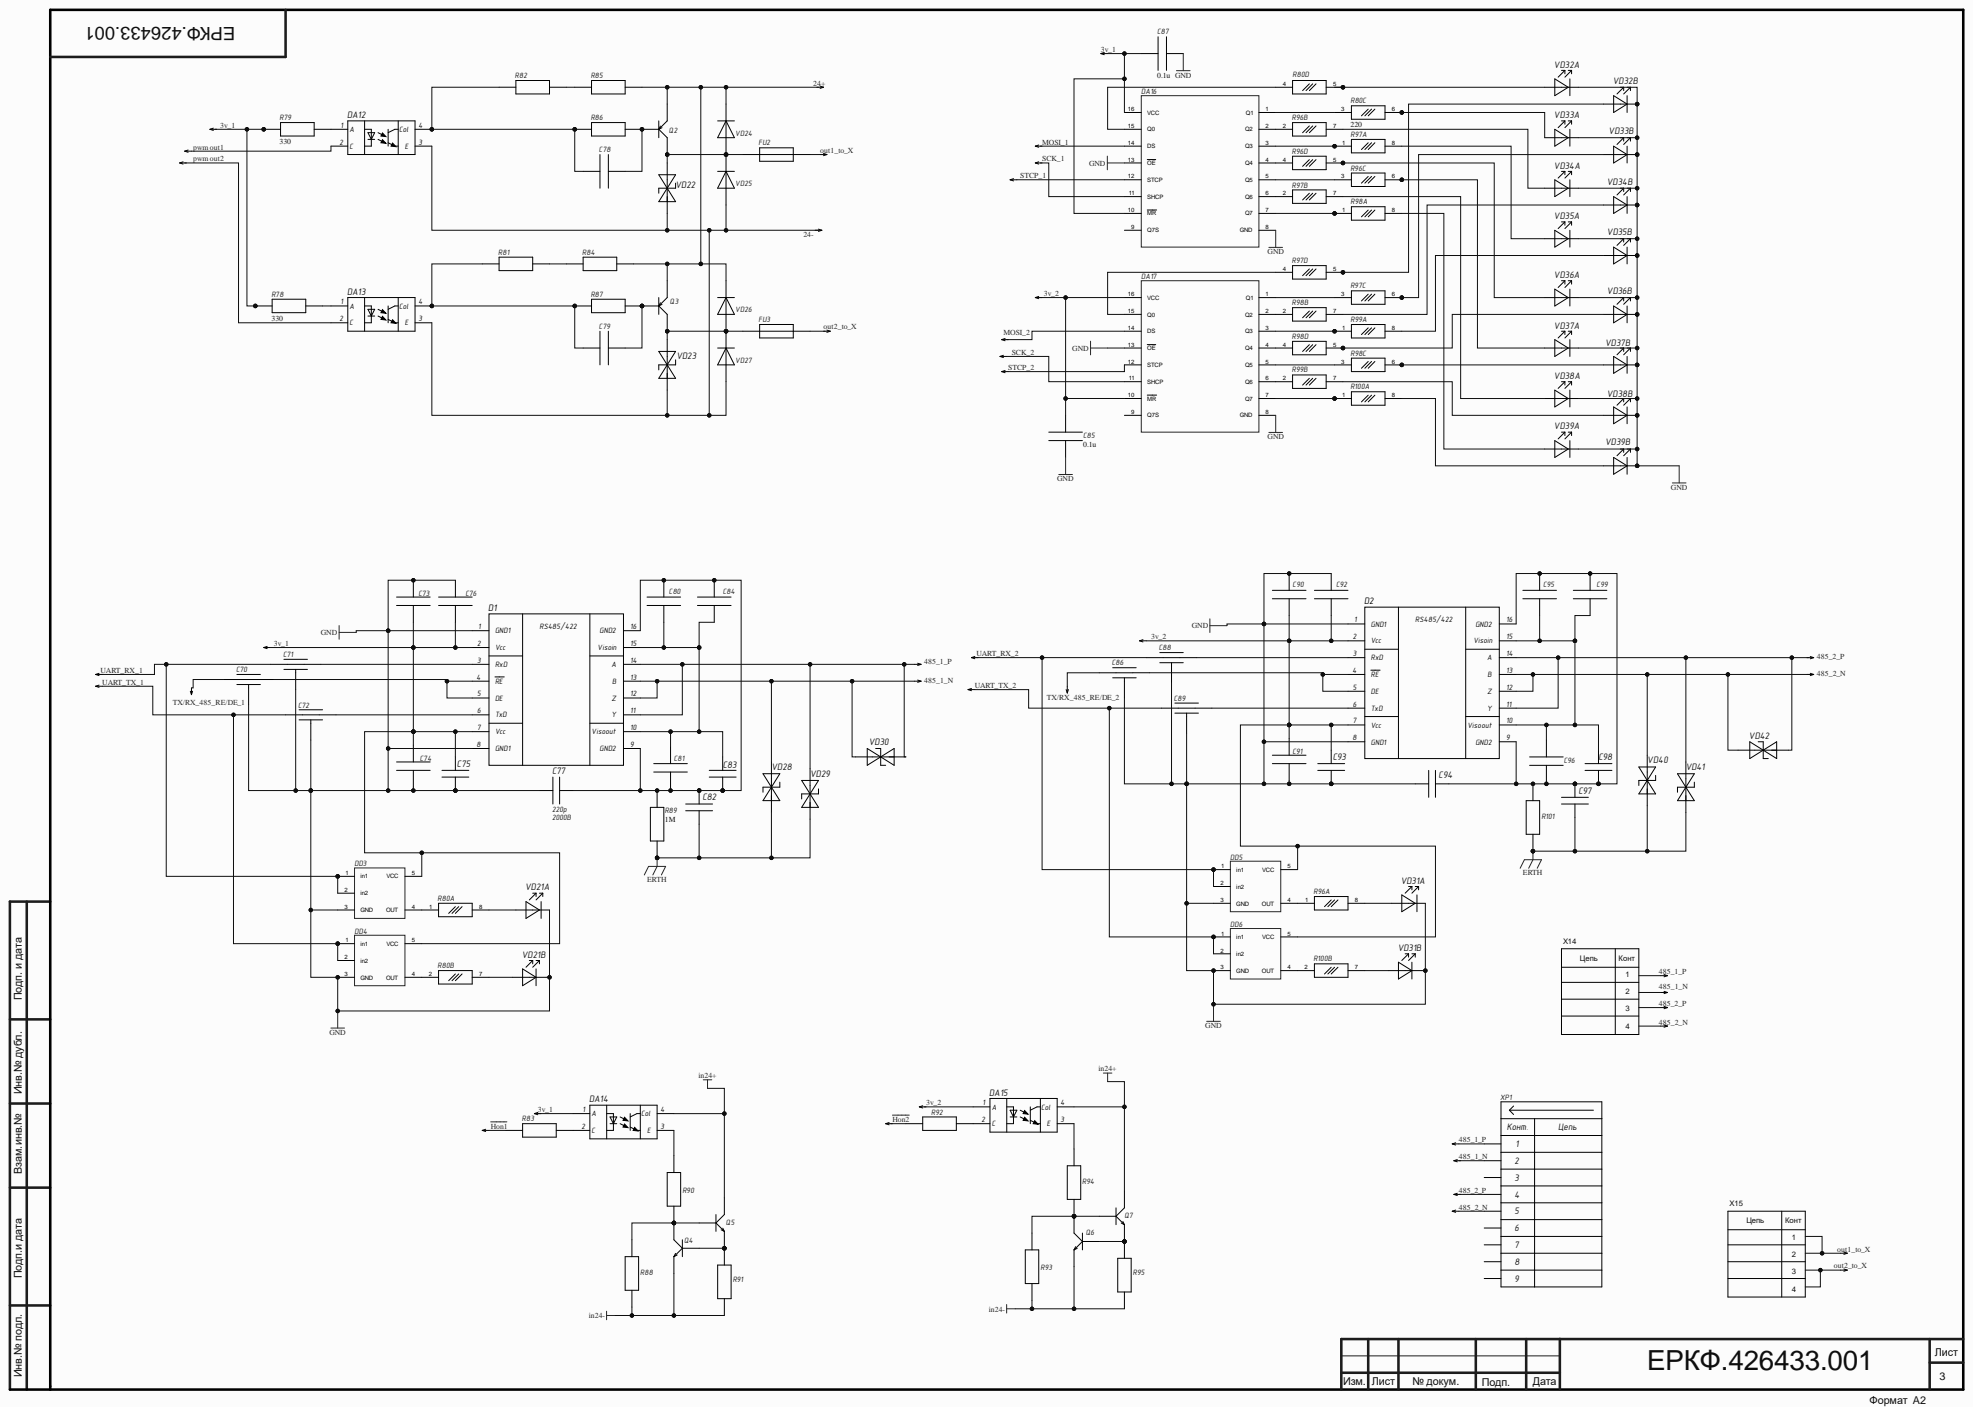
[picture p49: page 3]

SHCP 11 | R97B

SCK_2 | OE 13 | R98D

GND1 1 | Visoin

Vcc 2 | 15

Цепь | Конт

л. Подп.и дата Взам.инв.№

Конт. | Цепь

ЕРКФ.426433.001

Изм. | Лист | № докум. | Подп. | Дата
