zolotarev88/DI_sil3-4/DI/DI.pdf

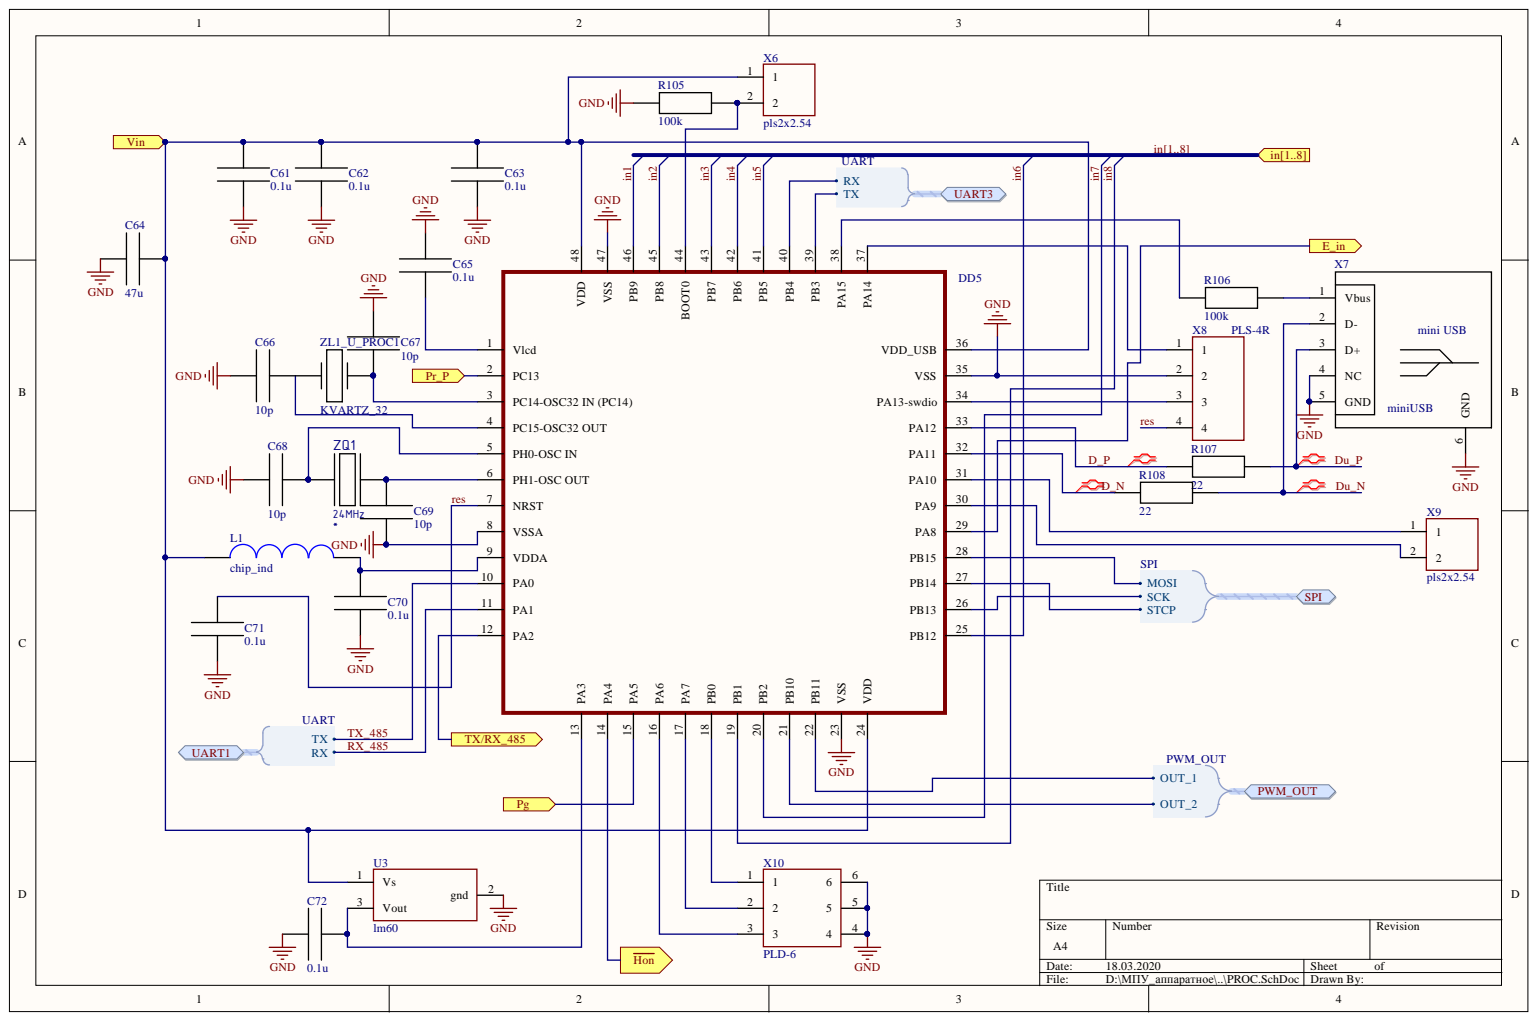
[picture p50: page 1]

Vlcd 1

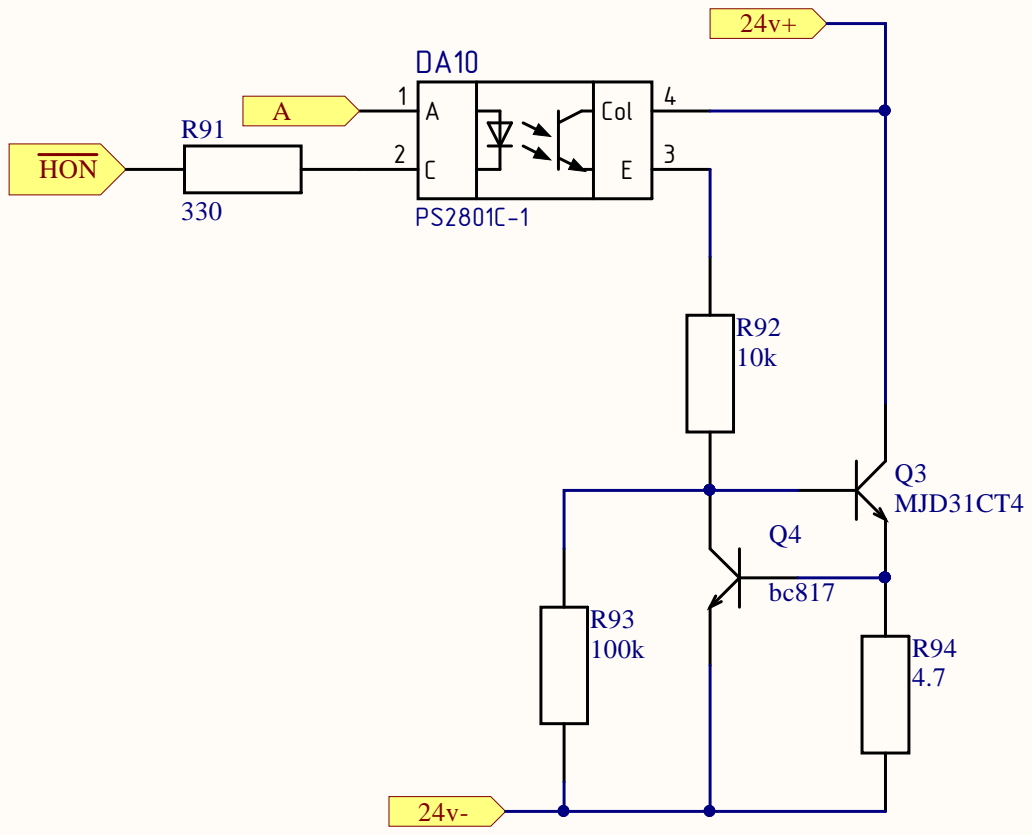
[picture p51: page 2]

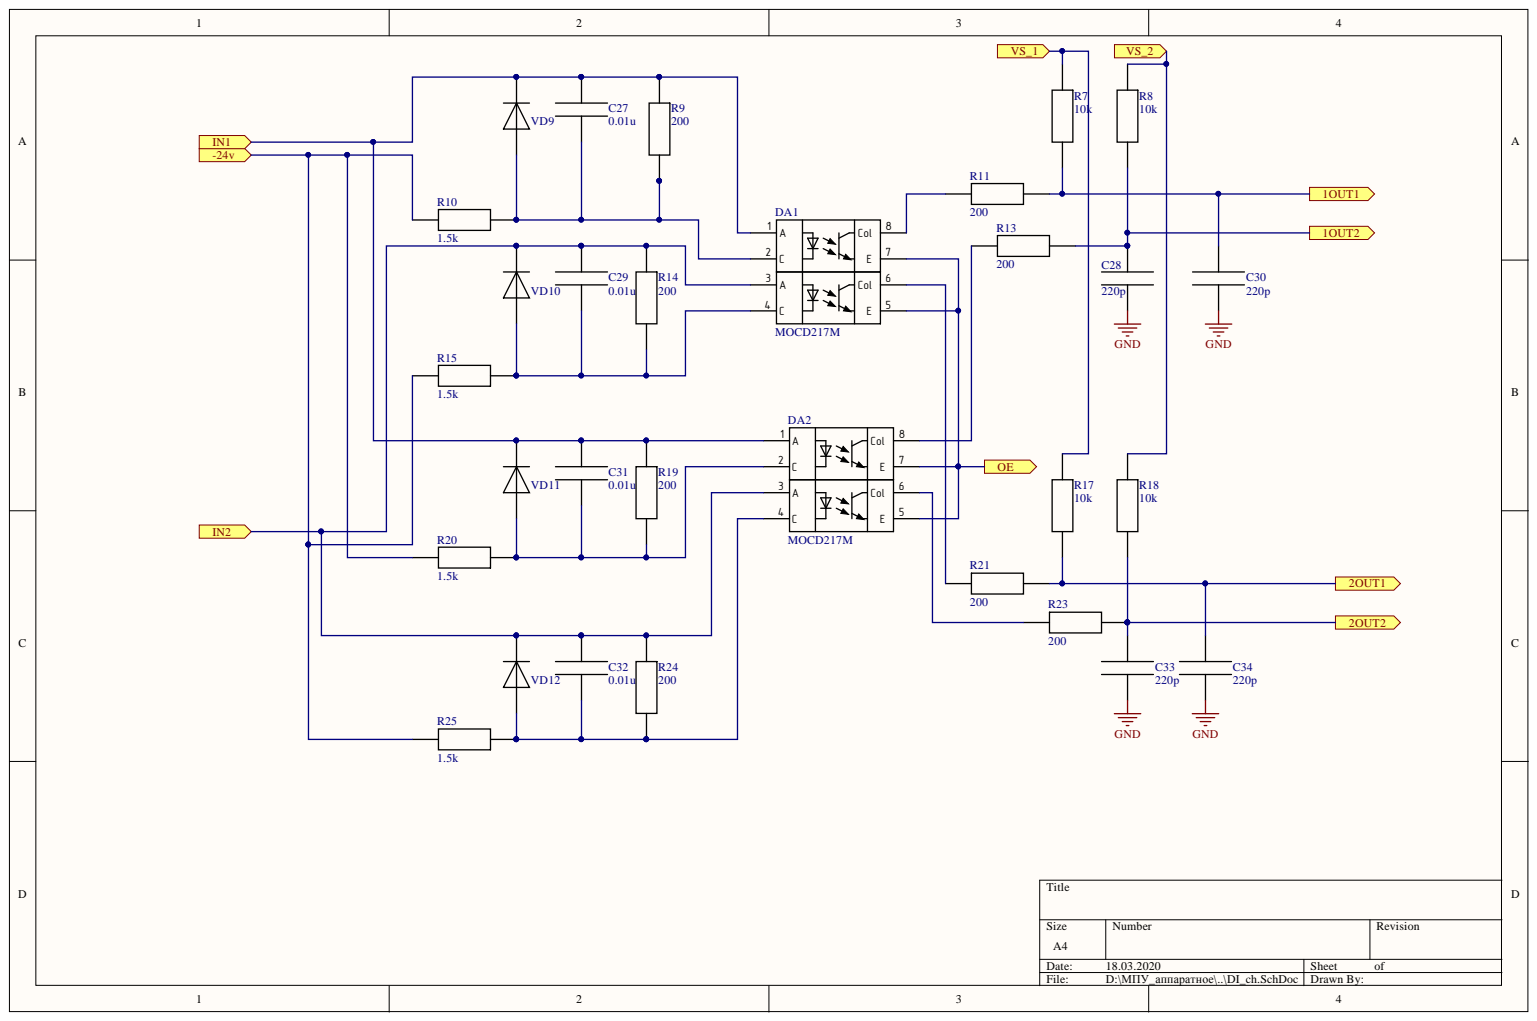
[picture p52: page 3]

A C | Col E

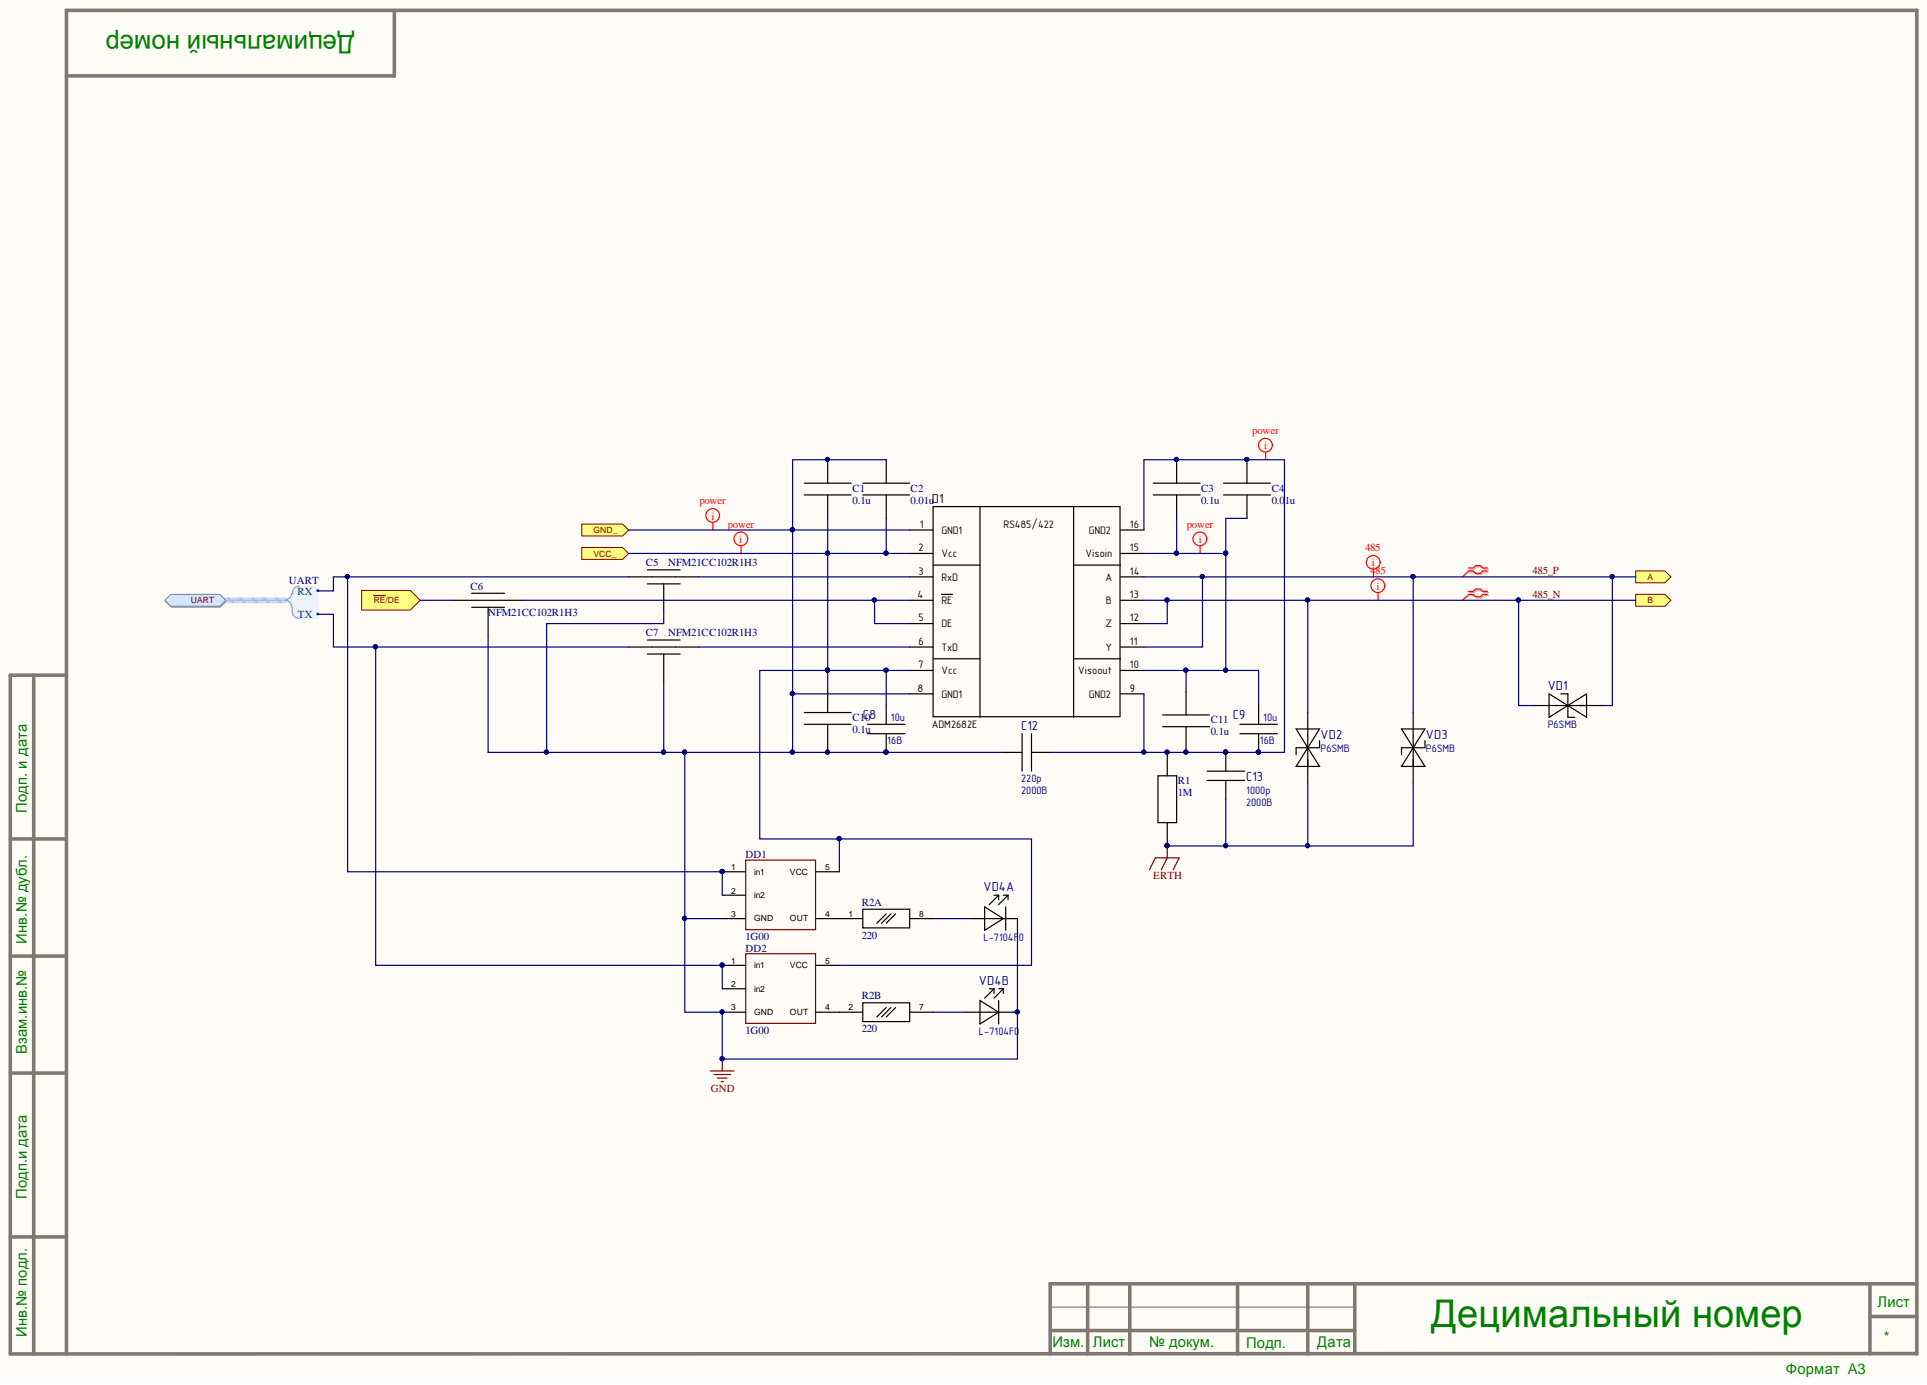
[picture p53: page 4]

V c c | R S 4 85/ 422 | G N D 2 Visoin
M2682E GND1 RxD R E D E TxD | | A B Z Y

7 | 1 0
V c c G N D 1 | Visoout G N D 2

Инв.№ подл. Подп.и дата Взам.инв.№ Инв.№ дубл.

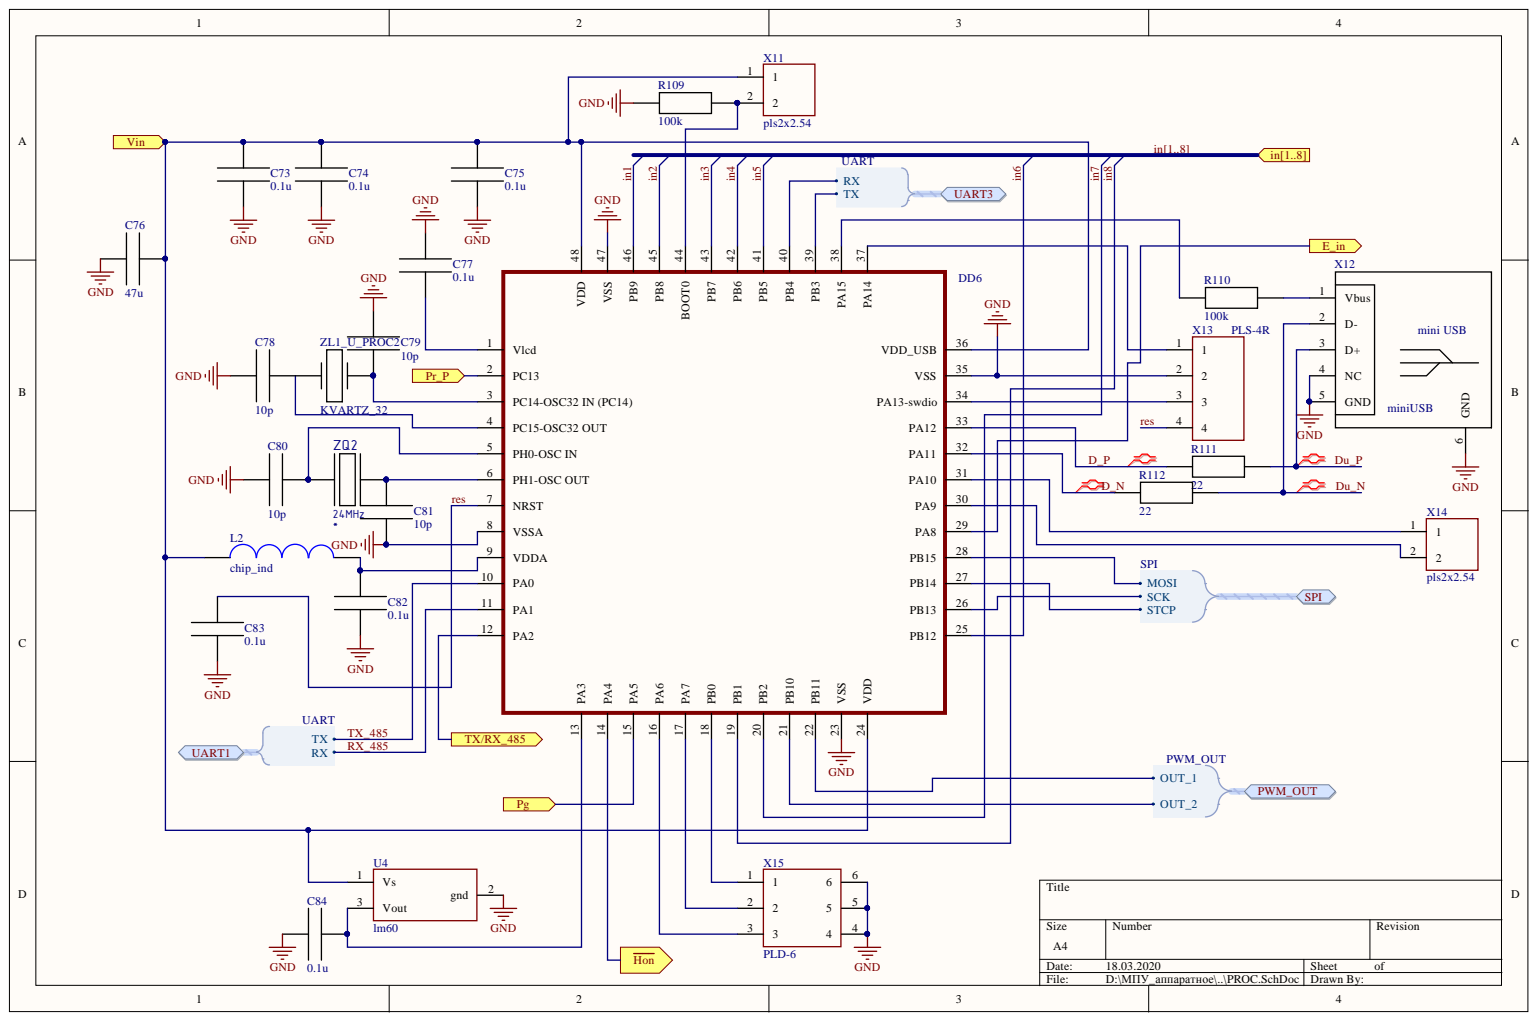
[picture p54: page 5]

Vlcd 1

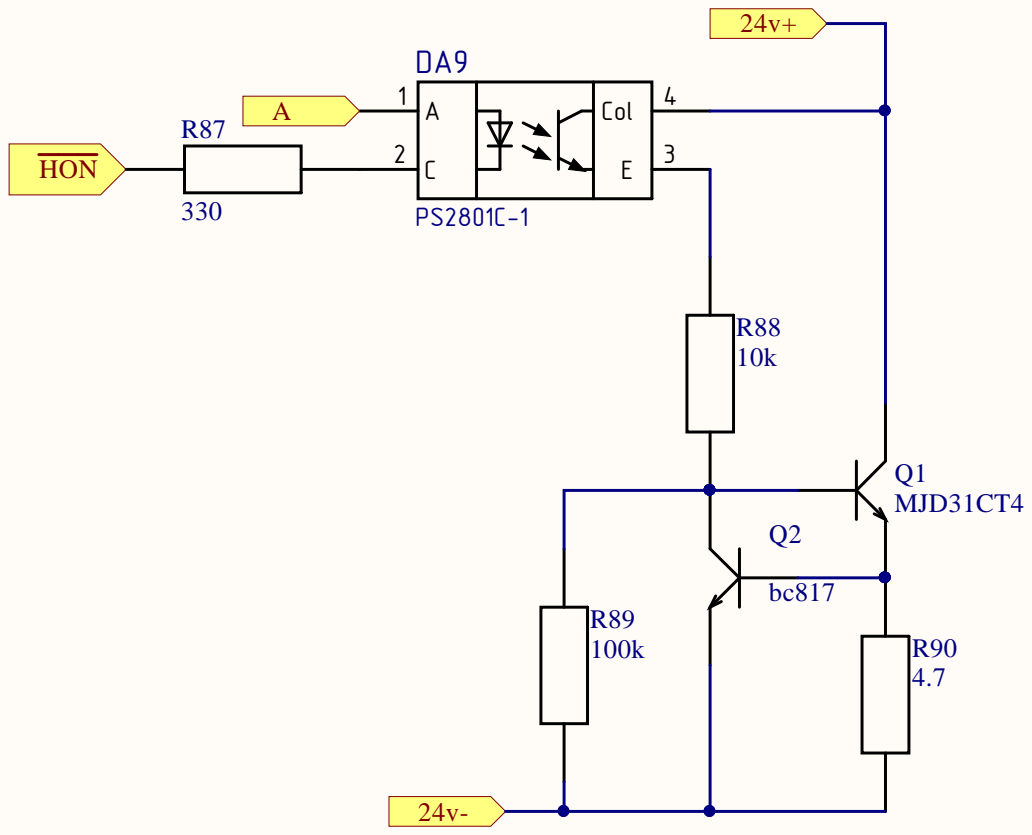
[picture p55: page 6]

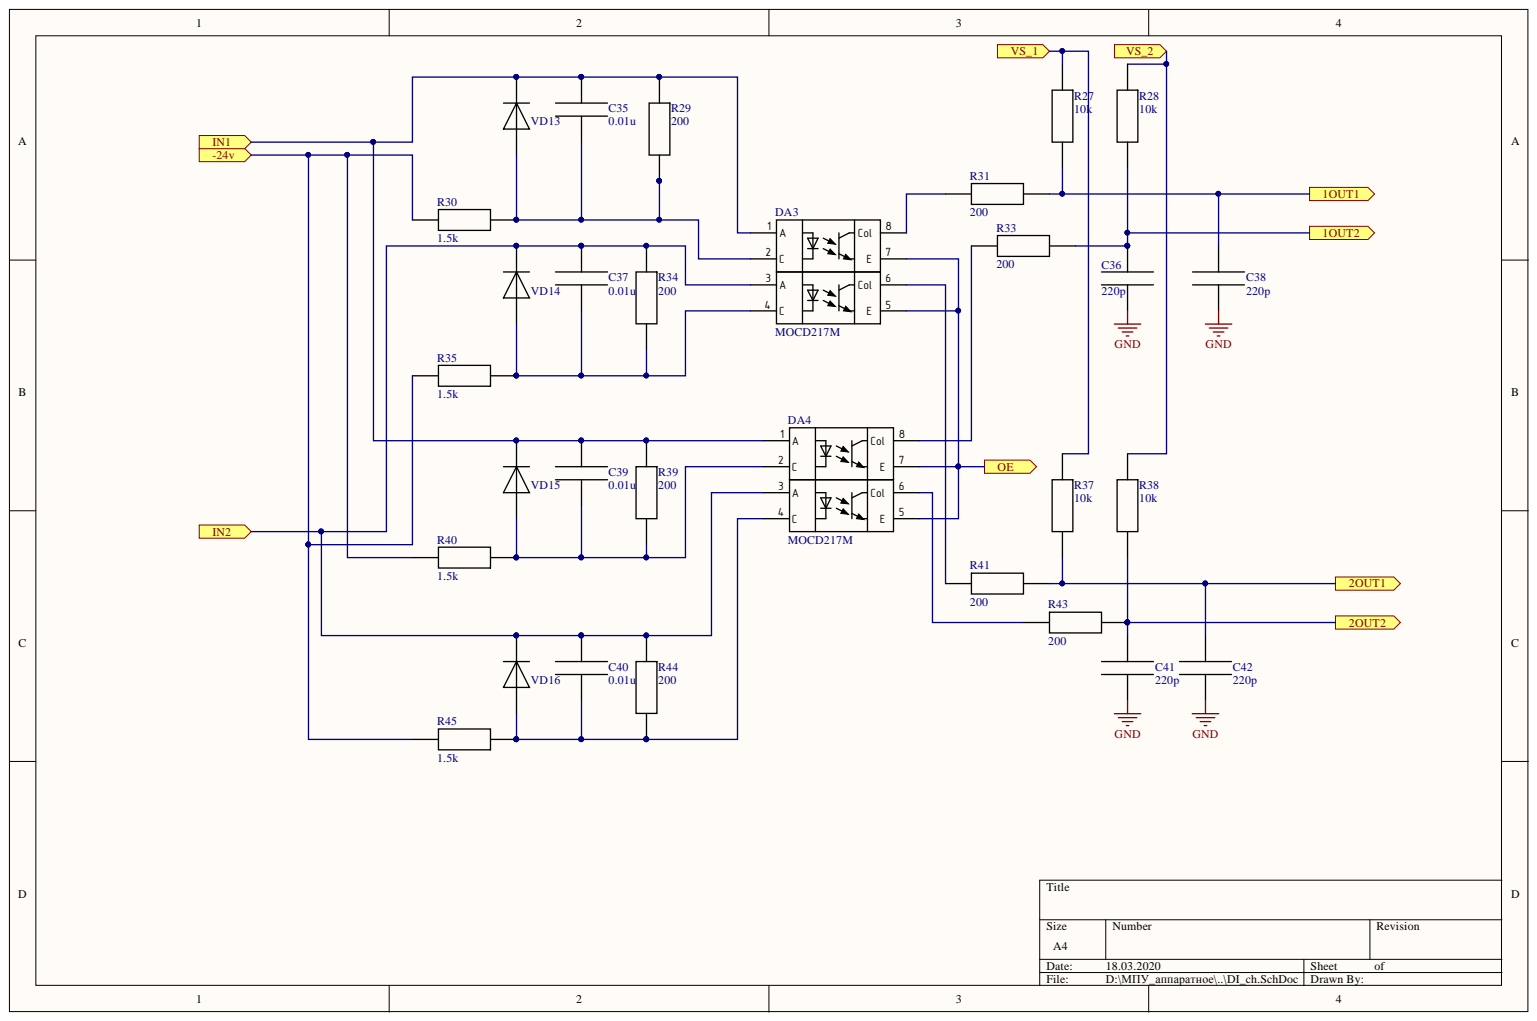
[picture p56: page 7]

A C | Col E

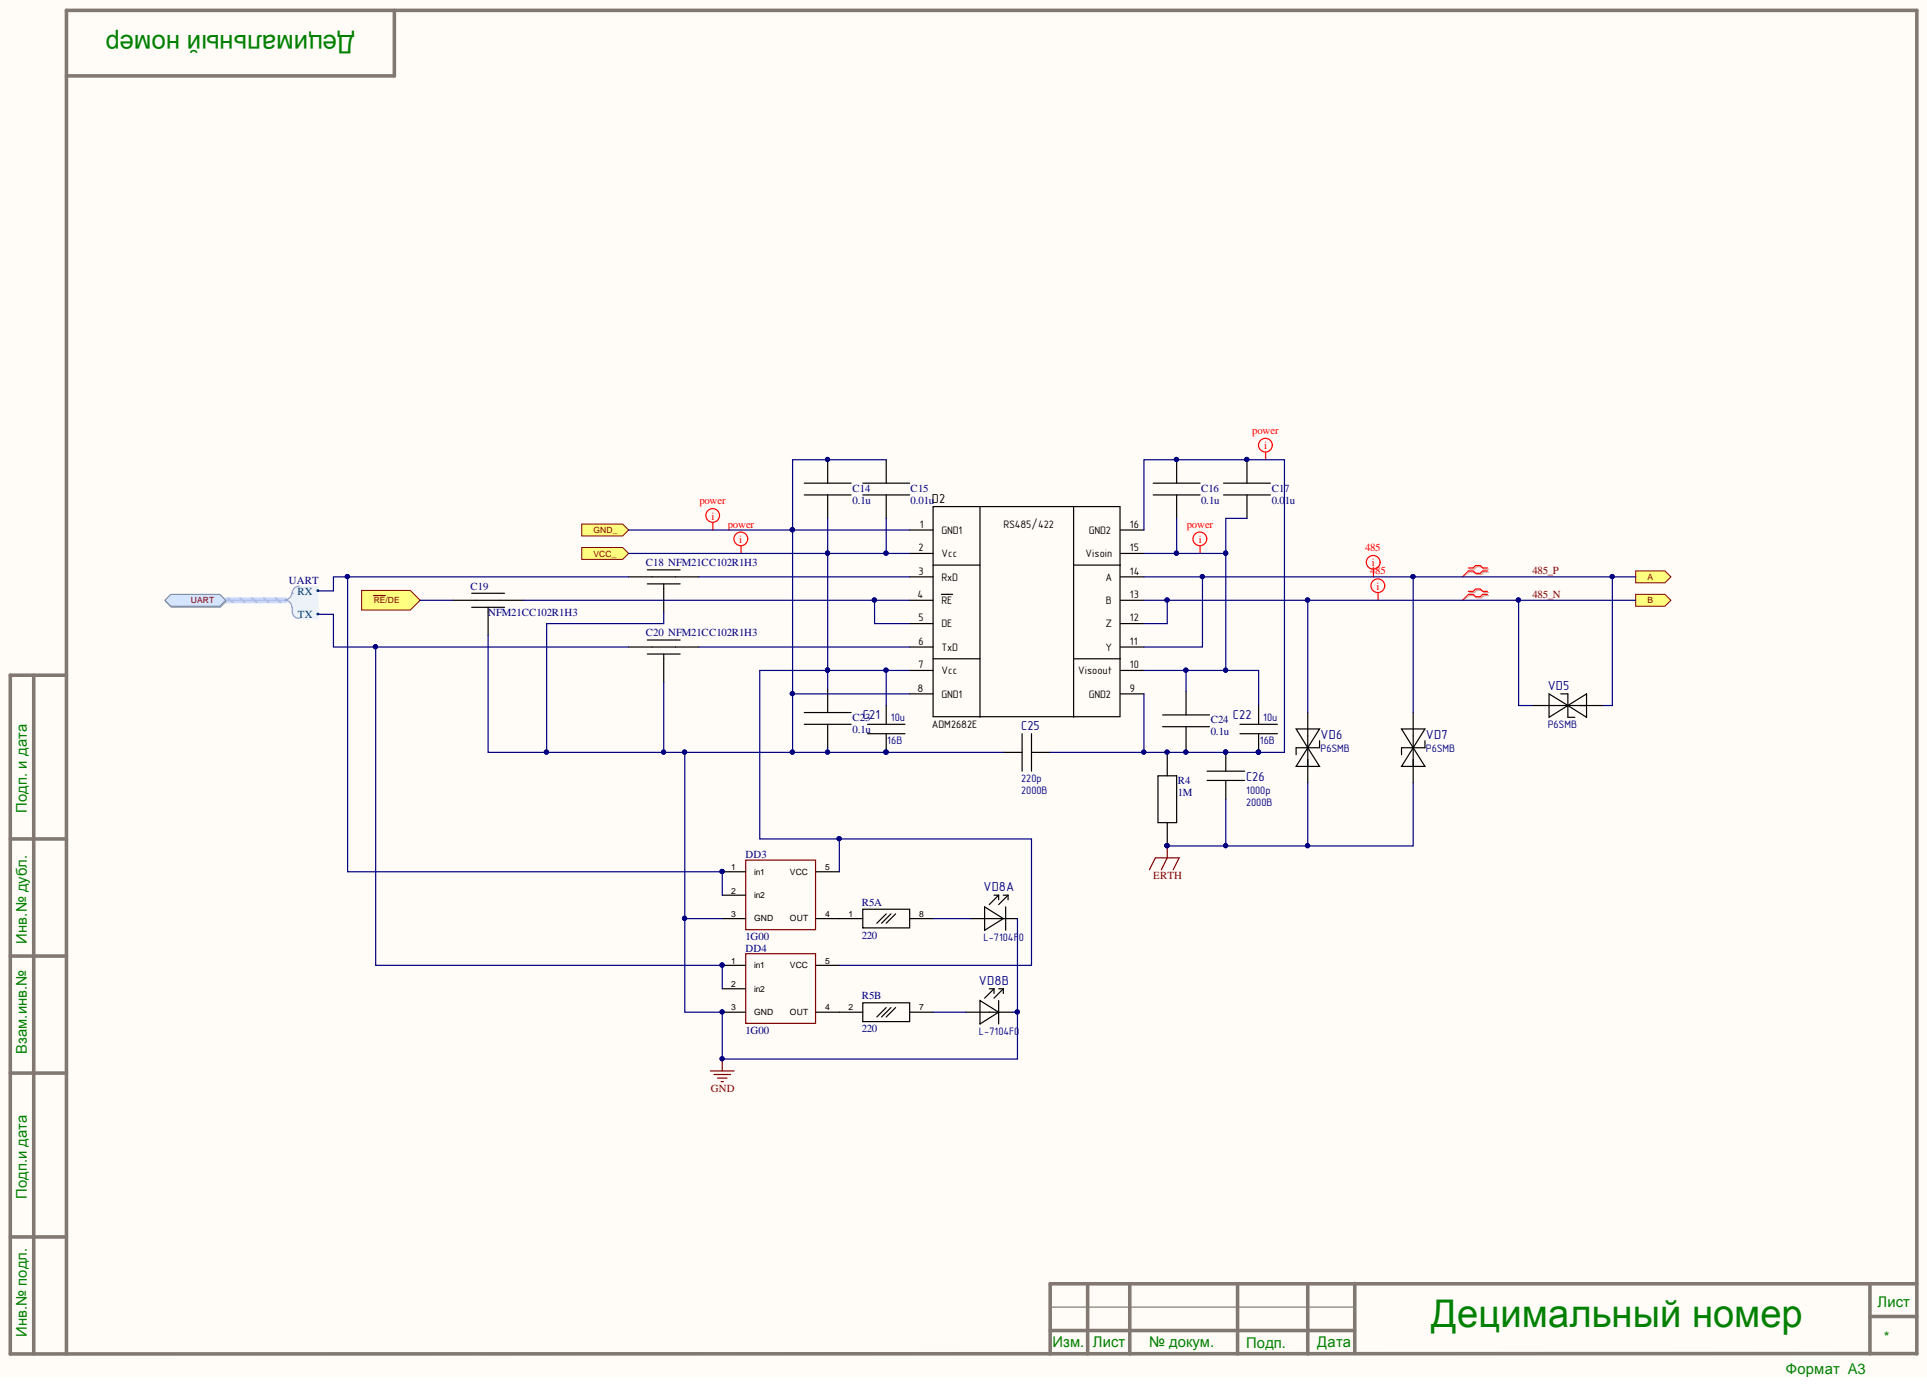
[picture p57: page 8]
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

7 | 1 0
V c c G N D 1 | Visoout G N D 2

Инв.№ подл. Подп.и дата Взам.инв.№ Инв.№ дубл.

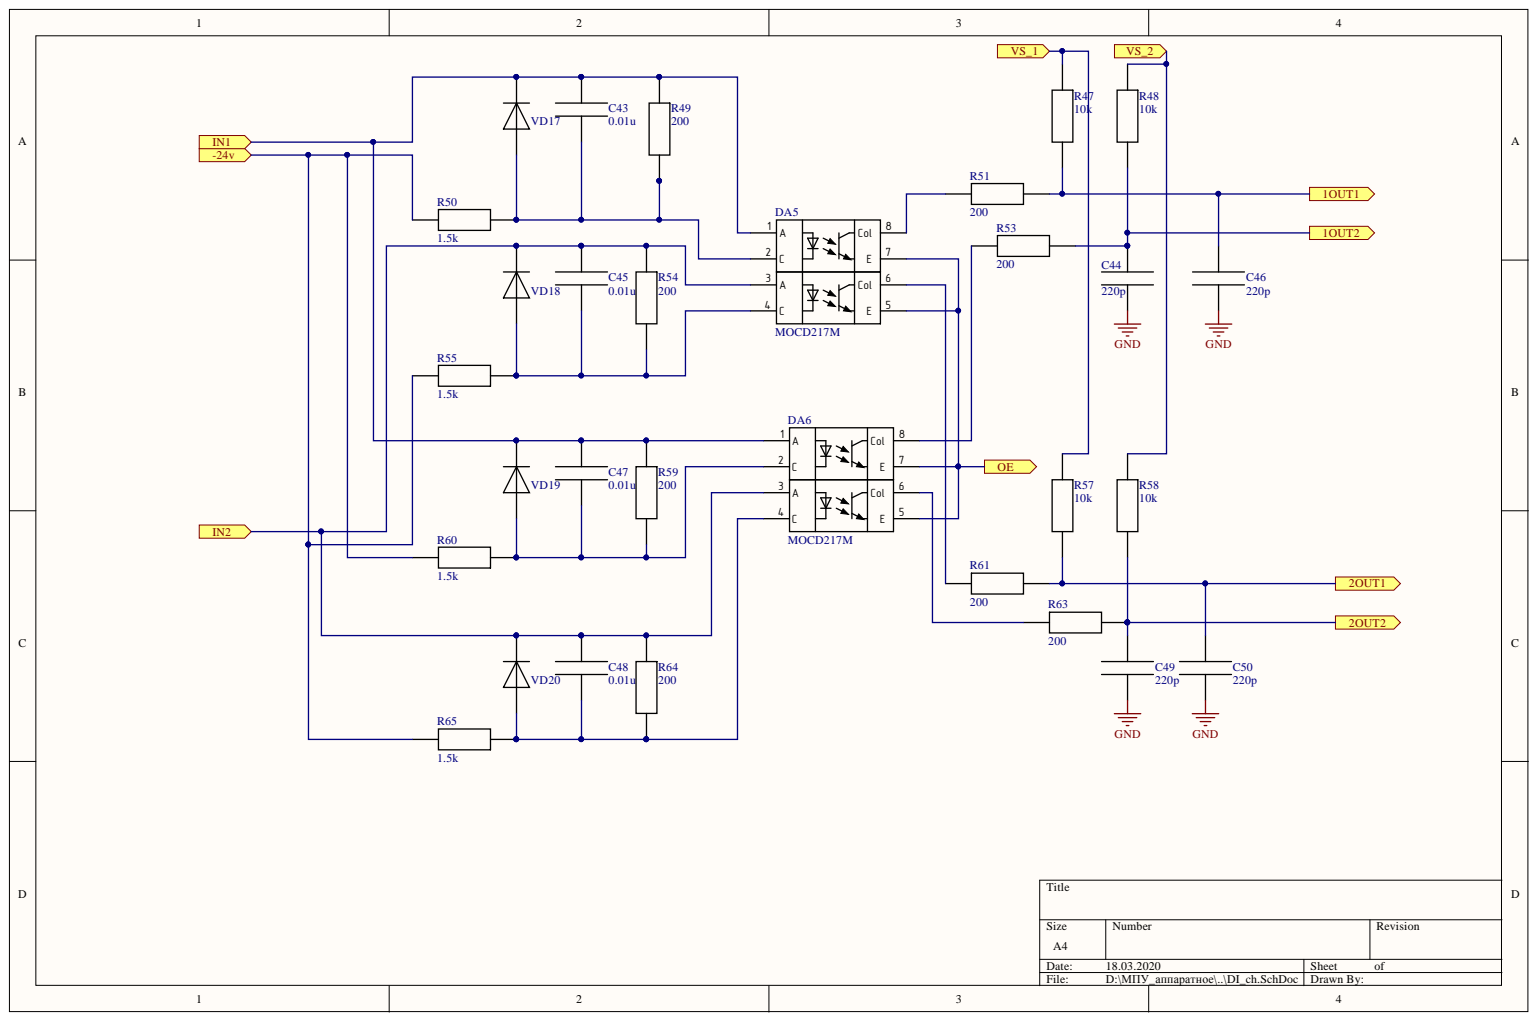
[picture p58: page 9]

A C | Col E

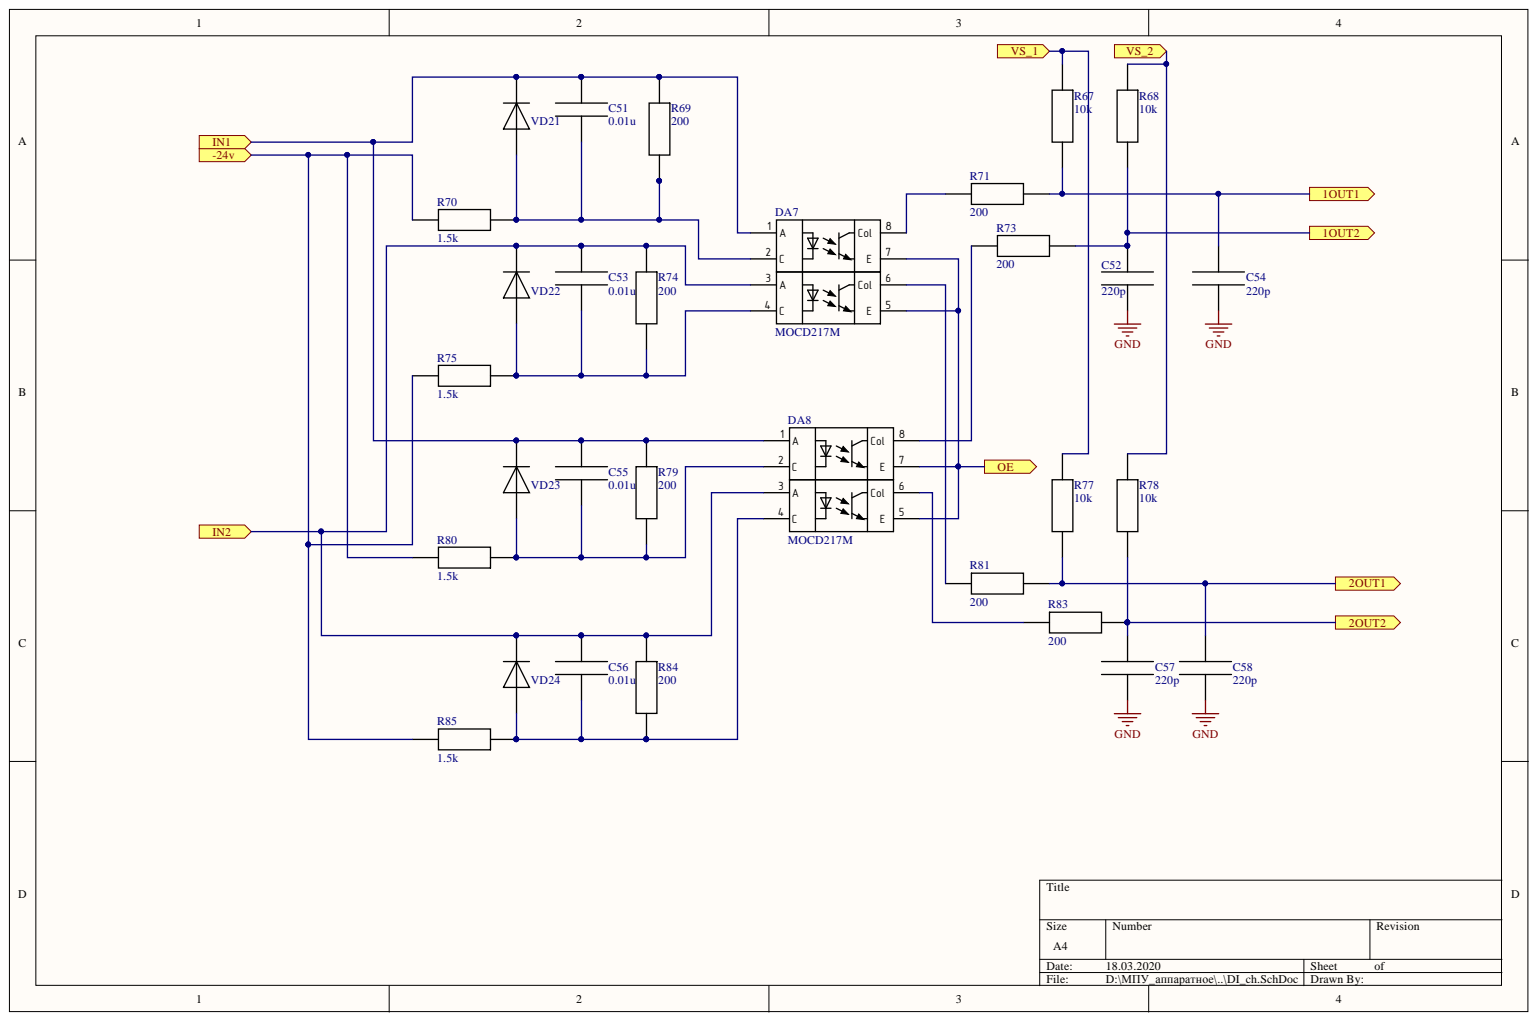
[picture p59: page 10]

A C | Col E

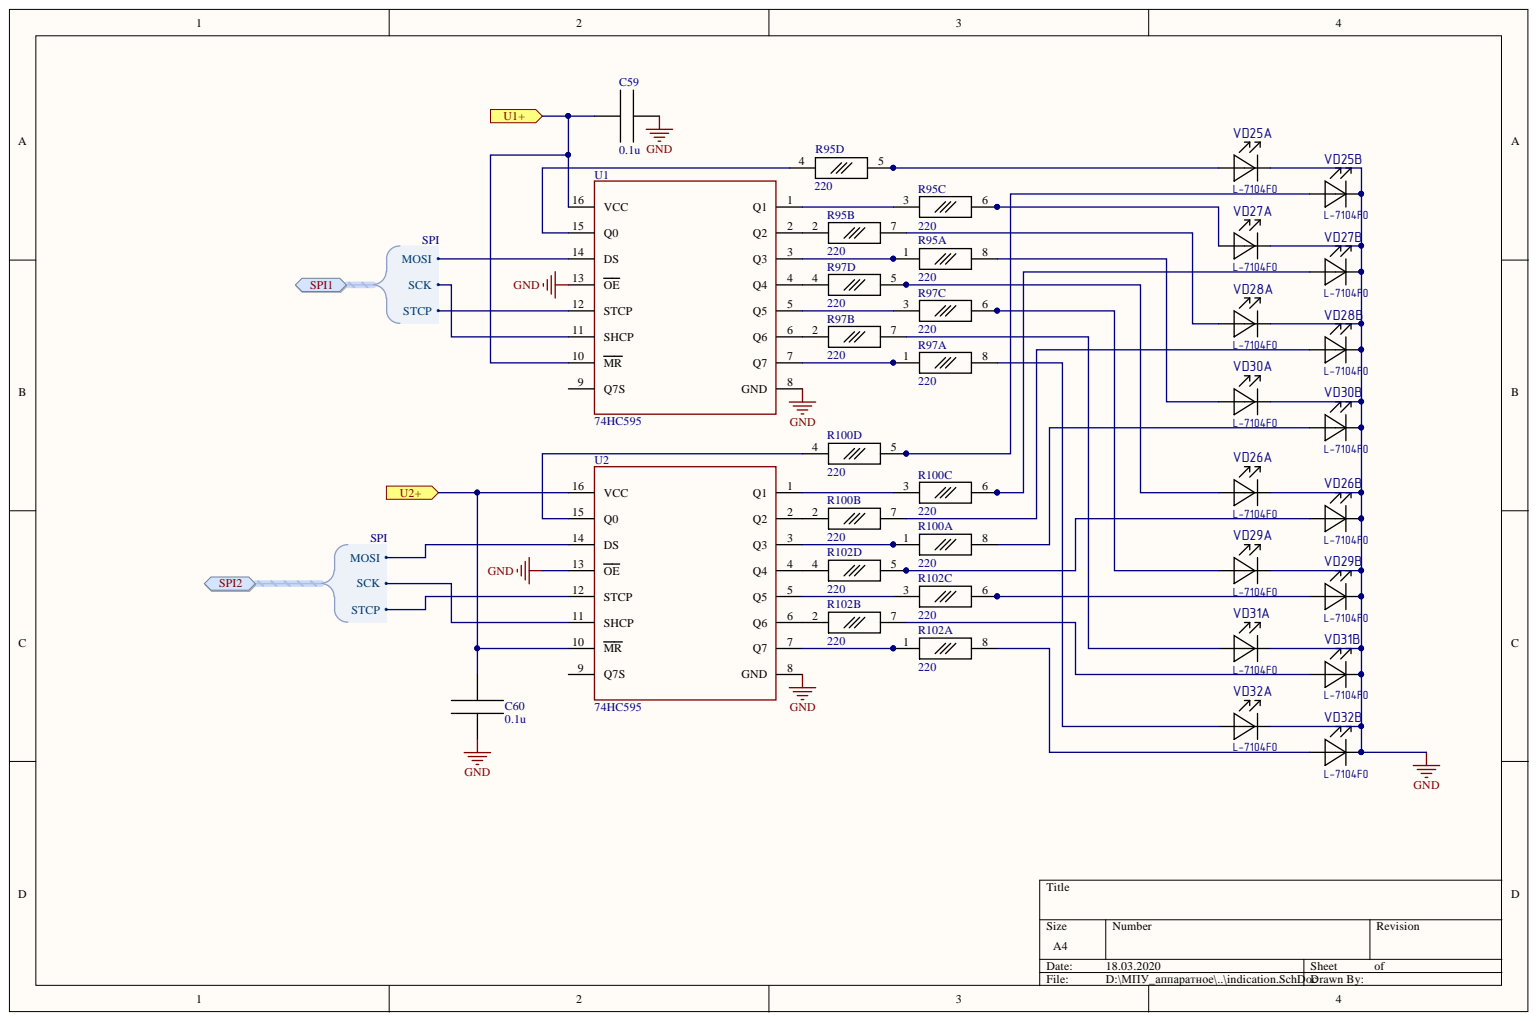
[picture p60: page 11]

L-7104F0
VD28A | VD28B

SHCP 11

VD30A | | VD30B

VD32A | VD32B

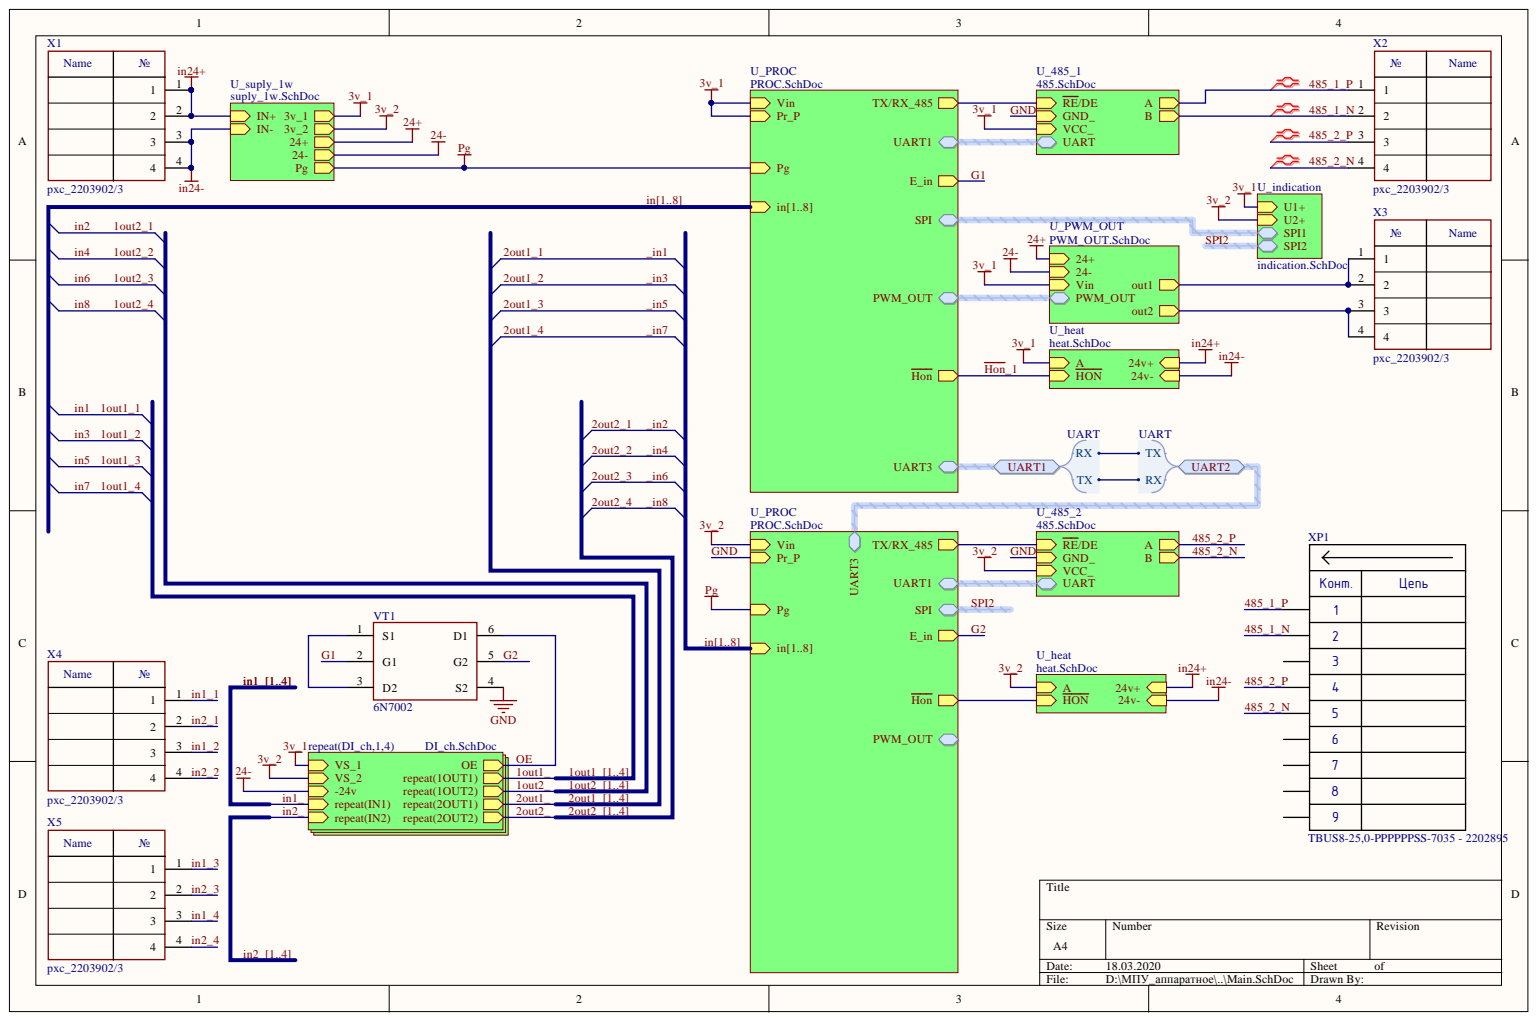
[picture p61: page 12]

RE/DE A GND_ B VCC_ UART

in2 1out2_1

2out2_1 2out2_2 2out2_3 2out2_4 | _in2 _in4 _in6 _in8

VS_1 OE VS_2 repeat(1OUT1)

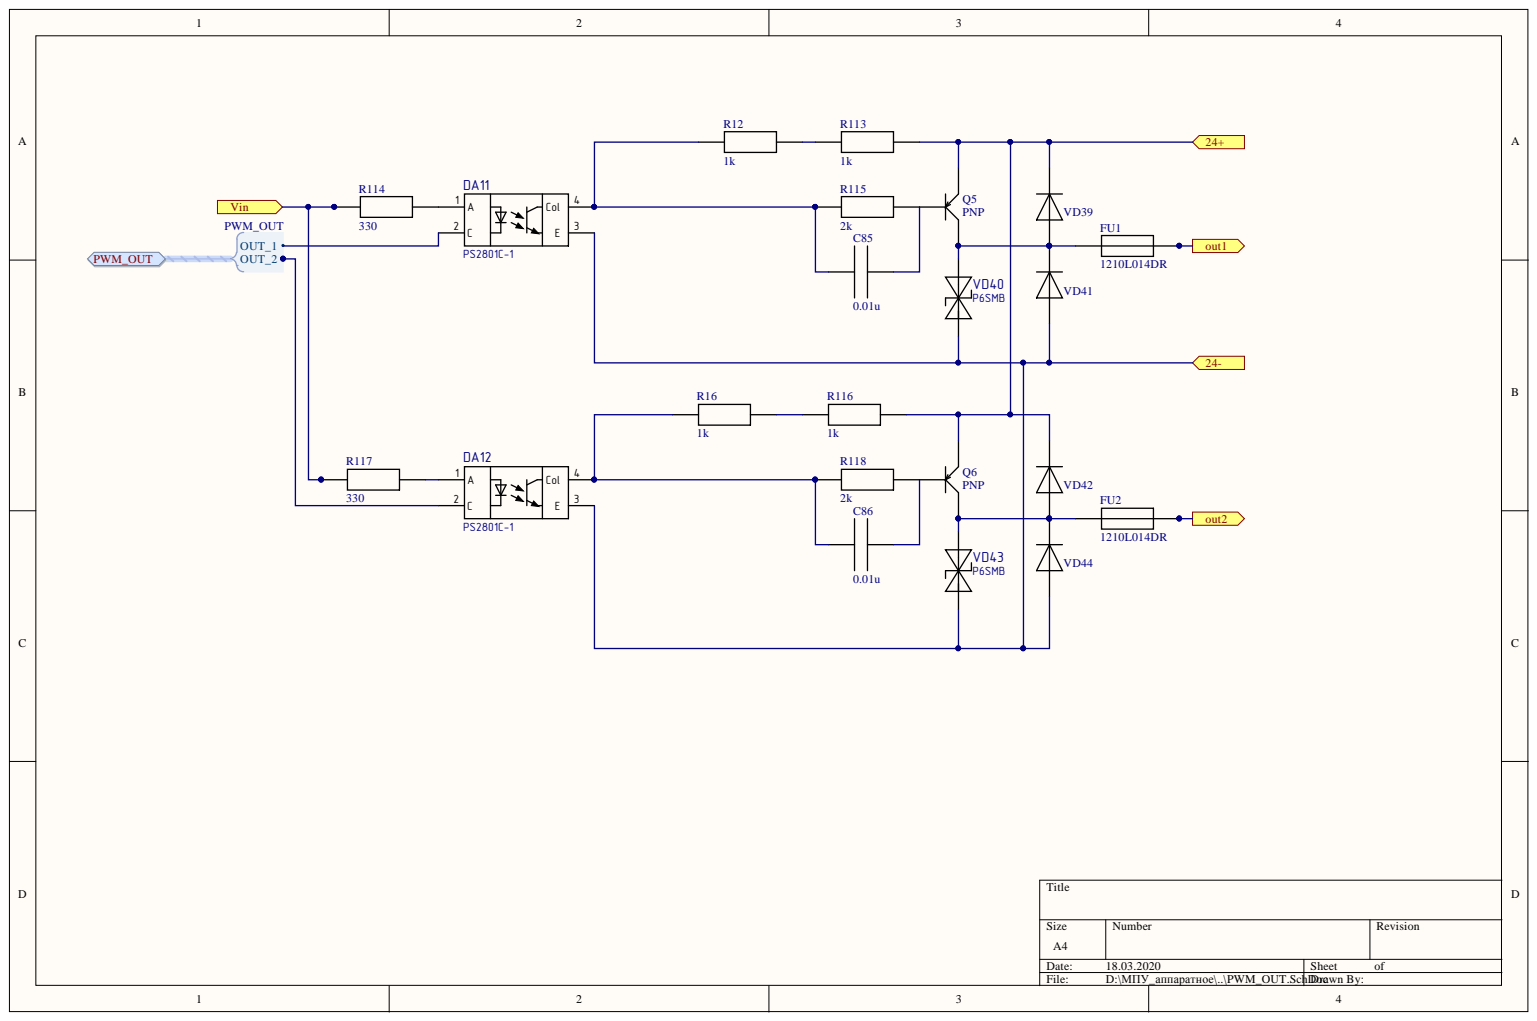
[picture p62: page 13]

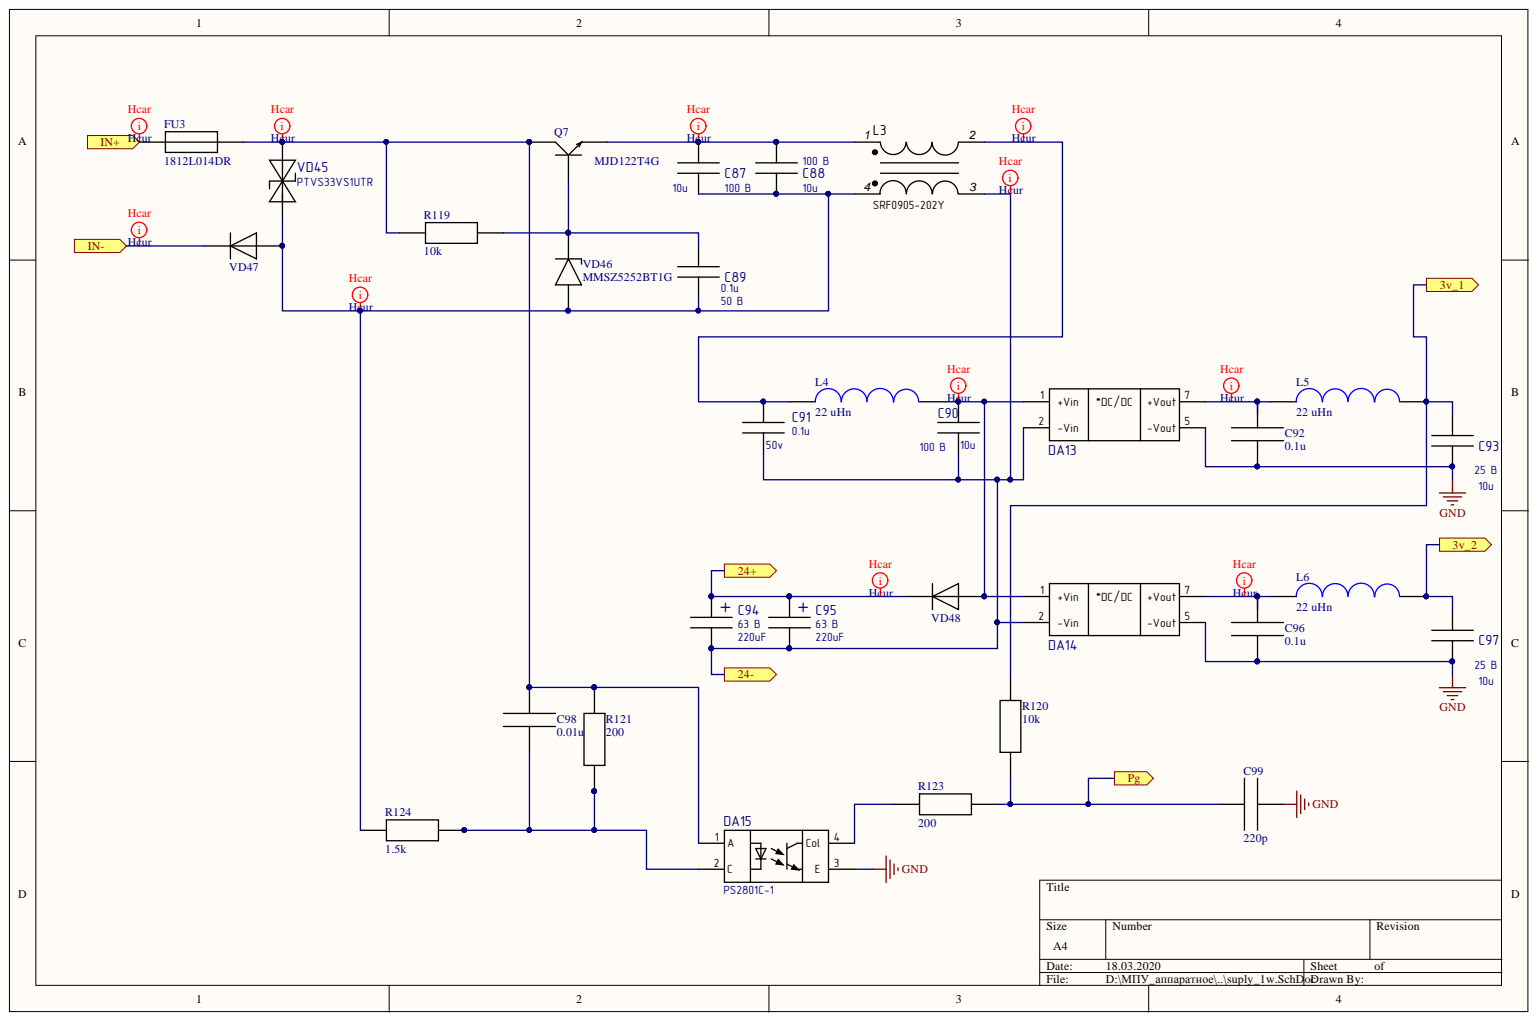
[picture p63: page 14]

+Vin 1 | +Vout | 7 *DC/DC

+Vin 1 | +Vout -Vout | 7 *DC/DC 5 -Vin 2

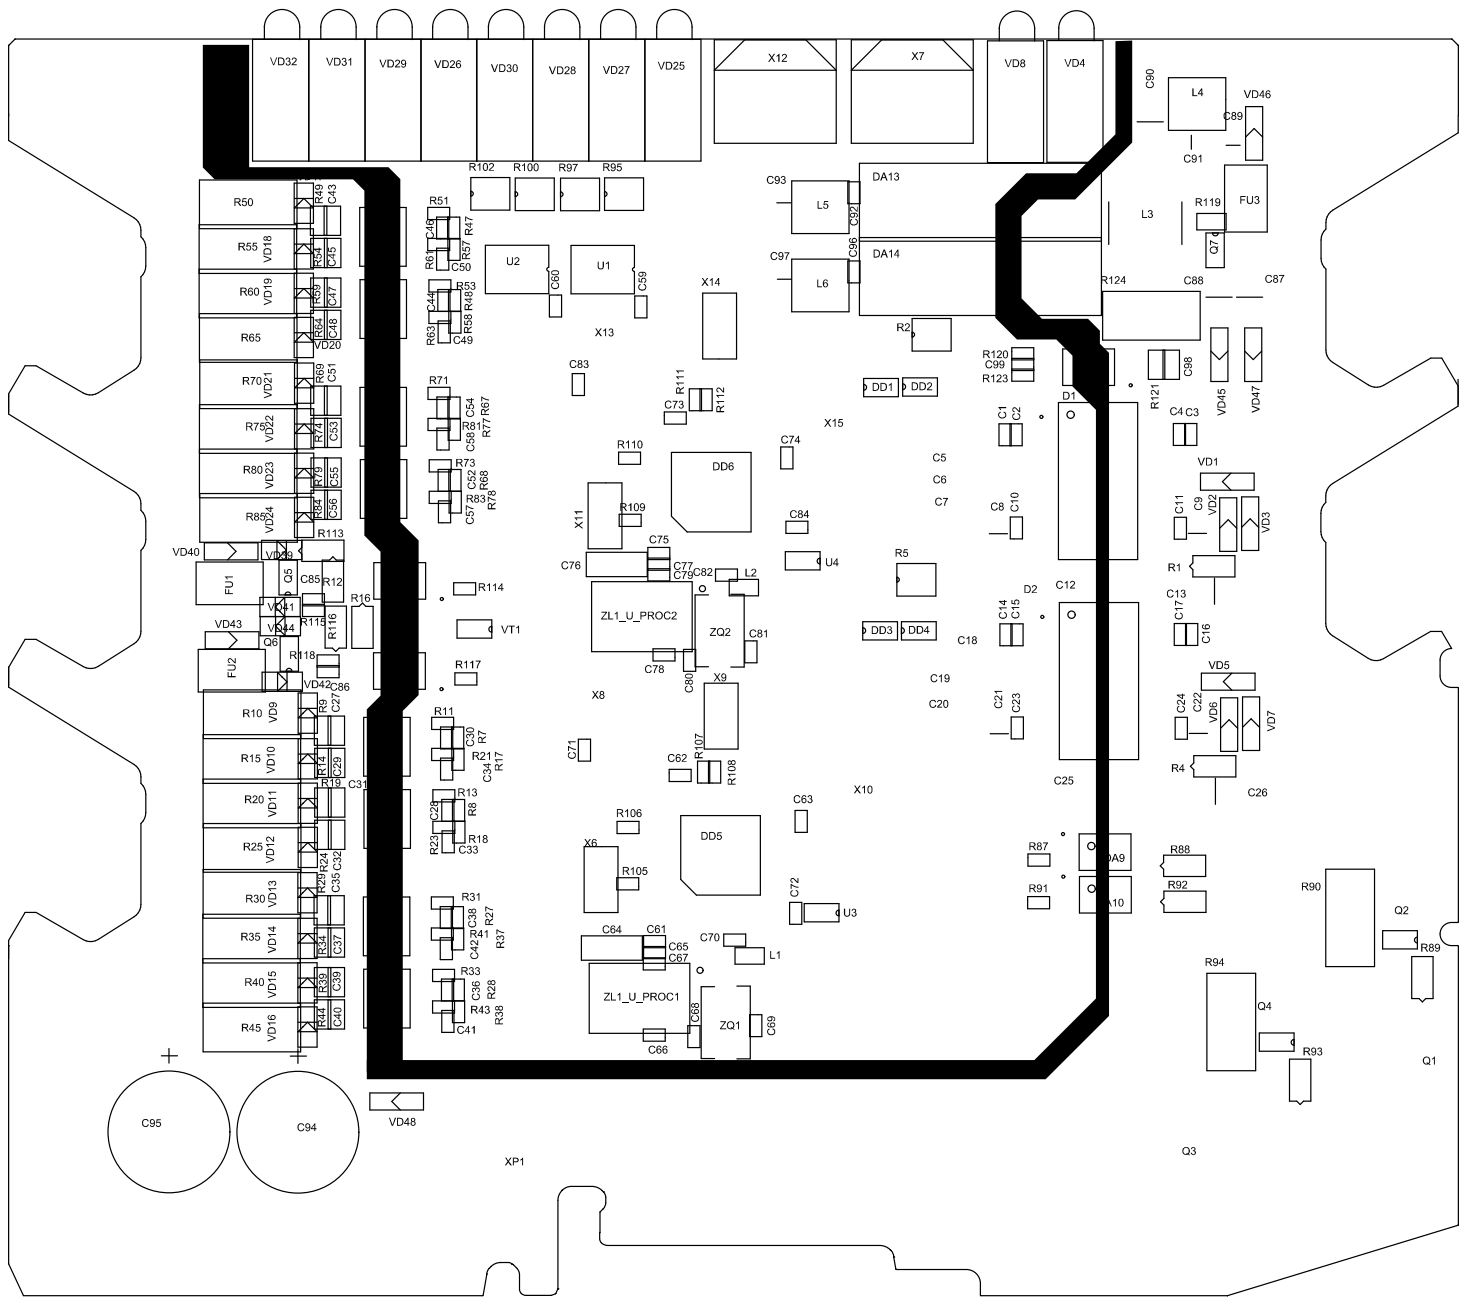
[picture p64: page 15]

# Board Stack Report
