zolotarev88/DI_sil3-4/DI/ЕРКФ.758725.093Д11_МОСК.pdf

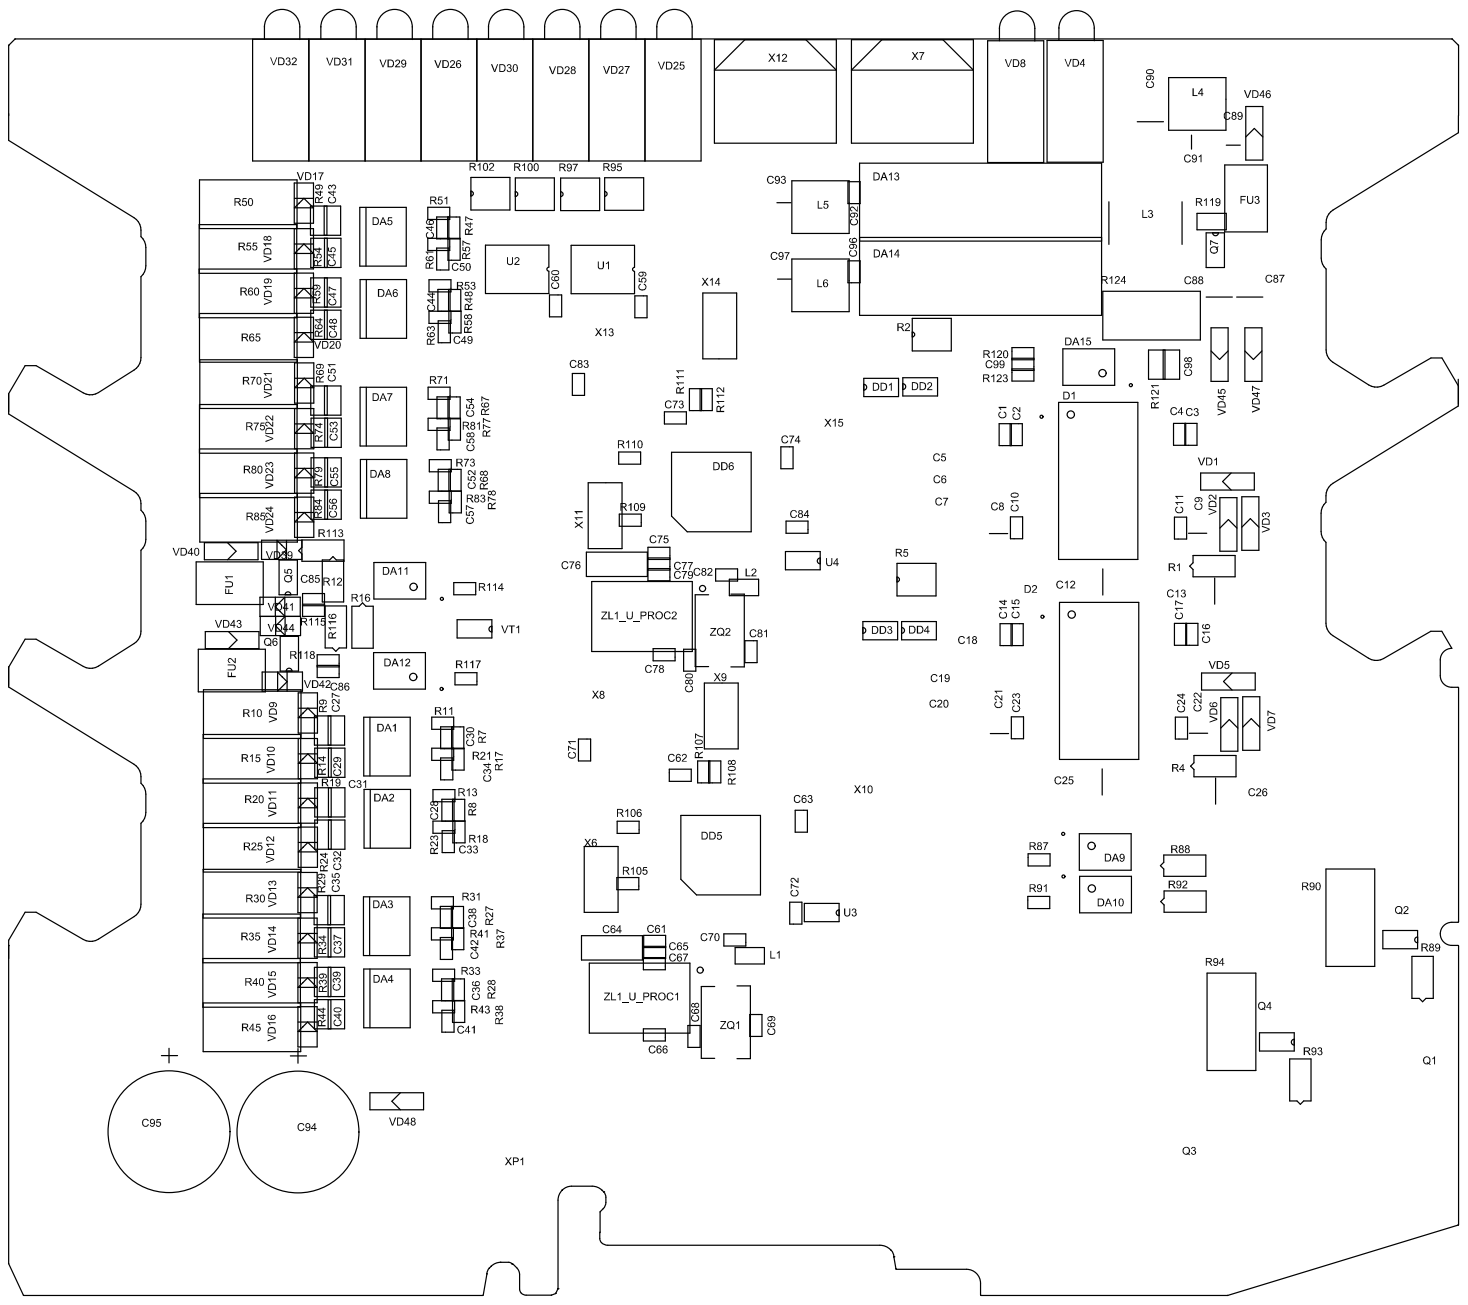
[picture p65: page 1]
