zolotarev88/DI_sil3-4/(list of files, drawings)

Other design files:
DI/485.SchDoc
DI/DI.PrjPcb
DI/DI_ch.SchDoc
DI/heat.SchDoc
DI/indication.SchDoc
DI/lib.SchLib
DI/Main.SchDoc
DI/PCB.PcbDoc
DI/PROC.SchDoc
DI/PWM_OUT.SchDoc
DI/sup&con.SchDoc
DI/SUPLY.SchDoc
DI/suply_1w.SchDoc
DI/work_pcb.PcbDoc
DI/Z_modem.SchDoc
npcprom/Connection.spl7
npcprom/DI.spl7
npcprom/head.spl7
npcprom/Sch.spl7
npcprom/SecondaryBoard.spl7
МВВ_передняя панель 2/МВВ_передняя панель 2/AD_LIB_npcprom/ADC.SchLib
МВВ_передняя панель 2/МВВ_передняя панель 2/AD_LIB_npcprom/Current Sensors.SchLib
МВВ_передняя панель 2/МВВ_передняя панель 2/AD_LIB_npcprom/DDS.SchLib
МВВ_передняя панель 2/МВВ_передняя панель 2/AD_LIB_npcprom/Digital Isolators.SchLib
МВВ_передняя панель 2/МВВ_передняя панель 2/AD_LIB_npcprom/Diode.PcbLib
МВВ_передняя панель 2/МВВ_передняя панель 2/AD_LIB_npcprom/Diode.SchLib
МВВ_передняя панель 2/МВВ_передняя панель 2/AD_LIB_npcprom/ESD protection.SchLib
МВВ_передняя панель 2/МВВ_передняя панель 2/AD_LIB_npcprom/Fuse.PcbLib
МВВ_передняя панель 2/МВВ_передняя панель 2/AD_LIB_npcprom/Fuse.SchLib
МВВ_передняя панель 2/МВВ_передняя панель 2/AD_LIB_npcprom/Interface_Transceiver.SchLib
МВВ_передняя панель 2/МВВ_передняя панель 2/AD_LIB_npcprom/Libs_AD_promelectronica.PrjPcb
МВВ_передняя панель 2/МВВ_передняя панель 2/AD_LIB_npcprom/Logic (1).SchLib
МВВ_передняя панель 2/МВВ_передняя панель 2/AD_LIB_npcprom/Logic.SchLib
МВВ_передняя панель 2/МВВ_передняя панель 2/AD_LIB_npcprom/Memory_EEPROM.SchLib
МВВ_передняя панель 2/МВВ_передняя панель 2/AD_LIB_npcprom/Memory_SDRAM.SchLib
МВВ_передняя панель 2/МВВ_передняя панель 2/AD_LIB_npcprom/Memory_SFLASH.SchLib
МВВ_передняя панель 2/МВВ_передняя панель 2/AD_LIB_npcprom/Microcontroller.SchLib
МВВ_передняя панель 2/МВВ_передняя панель 2/AD_LIB_npcprom/my_sch_lib.SchLib
МВВ_передняя панель 2/МВВ_передняя панель 2/AD_LIB_npcprom/OPA.SchLib
МВВ_передняя панель 2/МВВ_передняя панель 2/AD_LIB_npcprom/Optocoupler.SchLib
МВВ_передняя панель 2/МВВ_передняя панель 2/AD_LIB_npcprom/Oscillators.SchLib
МВВ_передняя панель 2/МВВ_передняя панель 2/AD_LIB_npcprom/Power_switches.SchLib
МВВ_передняя панель 2/МВВ_передняя панель 2/AD_LIB_npcprom/pre_CAPACITOR.PcbLib
МВВ_передняя панель 2/МВВ_передняя панель 2/AD_LIB_npcprom/pre_CAPACITOR.SchLib
МВВ_передняя панель 2/МВВ_передняя панель 2/AD_LIB_npcprom/pre_CONNECTOR.SchLib
МВВ_передняя панель 2/МВВ_передняя панель 2/AD_LIB_npcprom/pre_INDUCTOR.PcbLib
МВВ_передняя панель 2/МВВ_передняя панель 2/AD_LIB_npcprom/pre_INDUCTOR.SchLib
МВВ_передняя панель 2/МВВ_передняя панель 2/AD_LIB_npcprom/pre_MICROCIRCUITRY.PcbLib
МВВ_передняя панель 2/МВВ_передняя панель 2/AD_LIB_npcprom/pre_POWERSOURCE.SchLib
МВВ_передняя панель 2/МВВ_передняя панель 2/AD_LIB_npcprom/pre_RESISTOR.PcbLib
МВВ_передняя панель 2/МВВ_передняя панель 2/AD_LIB_npcprom/pre_RESISTOR.SchLib
МВВ_передняя панель 2/МВВ_передняя панель 2/AD_LIB_npcprom/Relay.PcbLib
МВВ_передняя панель 2/МВВ_передняя панель 2/AD_LIB_npcprom/Relay.SchLib
МВВ_передняя панель 2/МВВ_передняя панель 2/AD_LIB_npcprom/Surge_arrester.SchLib
МВВ_передняя панель 2/МВВ_передняя панель 2/AD_LIB_npcprom/Transformer - копия.SchLib
МВВ_передняя панель 2/МВВ_передняя панель 2/AD_LIB_npcprom/Transformer.PcbLib
МВВ_передняя панель 2/МВВ_передняя панель 2/AD_LIB_npcprom/Transformer.SchLib
МВВ_передняя панель 2/МВВ_передняя панель 2/AD_LIB_npcprom/TRANSISTOR.PcbLib
МВВ_передняя панель 2/МВВ_передняя панель 2/AD_LIB_npcprom/TRANSISTOR.SchLib
МВВ_передняя панель 2/МВВ_передняя панель 2/AD_LIB_npcprom/Voltage References.SchLib
МВВ_передняя панель 2/МВВ_передняя панель 2/AD_LIB_npcprom/ЕРКФ.426477.005.PcbLib
МВВ_передняя панель 2/МВВ_передняя панель 2/AD_LIB_npcprom/ЕРКФ.426477.005.SCHLIB
МВВ_передняя панель 2/МВВ_передняя панель 2/AD_LIB_npcprom/ЕРКФ.426477.005Э3.SchLib
МВВ_передняя панель 2/МВВ_передняя панель 2/AD_LIB_npcprom/Рositioning_elements.PcbLib
МВВ_передняя панель 2/МВВ_передняя панель 2/AD_LIB_npcprom/Рositioning_elements.SchLib
МВВ_передняя панель 2/МВВ_передняя панель 2/lib.SchLib
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
