zolotarev88/DI_sil3-4/DI_prog/DI_prog.ioc

Mcu.UserName=STM32L073CBTx
PA0.Signal=USART4_TX
PA1.Signal=USART4_RX
PA10.Signal=USART1_RX
PA11.Signal=USB_DM
PA12.Signal=USB_DP
PA13.Signal=SYS_SWDIO
PA14.Signal=SYS_SWCLK
PA2.Signal=GPIO_Output
PA9.Signal=USART1_TX
PB13.Signal=SPI2_SCK
PB14.Signal=GPIO_Output
PB15.Signal=SPI2_MOSI
PB3.Signal=USART5_TX
PB4.Signal=USART5_RX
PC14-OSC32_IN.Signal=RCC_OSC32_IN
PC15-OSC32_OUT.Signal=RCC_OSC32_OUT
PH0-OSC_IN.Signal=RCC_OSC_IN
PH1-OSC_OUT.Signal=RCC_OSC_OUT
