zolotarev88/DI_sil3-4/(commit log)

2020-03-05 first commit_
    [ADC.SchLib, Current Sensors.SchLib, DDS.SchLib, DI.PrjPcb, DI_ch.SchDoc, Digital Isolators.SchLib, Diode.PcbLib, Diode.SchLib]
2020-03-06 main crate
    [485.SchDoc, DI.PrjPcb, Main.SchDoc, PROC.SchDoc, PWM_OUT.SchDoc, heat.SchDoc, suply_1w.SchDoc]
2020-03-10 start pcb
    [DI.PrjPcb, DI_ch.SchDoc, ICC25-H-4L5.0__01080961_H.Select.stp, ICC25-H-4R5.0__01083879_H.Select.stp, Main.SchDoc, PCB-FRAGMENT_ICC25-H_4L5.0_01084043.stp, PCB-FRAGMENT_ICC25-H_4R5.0_01087108.stp, PCB.PcbDoc]
2020-03-11 начал плату
    [485.SchDoc, DI.PrjPcb, DI_ch.SchDoc, Main.SchDoc, PROC.SchDoc, PWM_OUT.SchDoc, Z_modem.SchDoc, heat.SchDoc]
2020-03-13 расставил все компоненты
    [485.SchDoc, DI.PrjPcb, Main.SchDoc, PROC.SchDoc, suply_1w.SchDoc]
2020-03-16 почти разьвел
    [DI.PrjPcb, suply_1w.SchDoc]
2020-03-16 остался шелк
    [indication.SchDoc]
2020-03-17 готова разводка
    [485.SchDoc, DI.PrjPcb, DI.xls, DI_ch.SchDoc, PROC.SchDoc, PWM_OUT.SchDoc, suply_1w.SchDoc]
2020-03-18 сгенерил герберы
    [DI.PrjPcb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]
2020-04-20 new gerbers
    [DI.PrjPcb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]
2020-04-20 new gerbers_3
    [DI.PrjPcb, DI.xls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]
2022-09-12 new version start
    [485.SchDoc, ADC.SchLib, Connection.spl7, Current Sensors.SchLib, DDS.SchLib, DI.spl7, DI_перечень.xlsx, Digital Isolators.SchLib]
2022-09-12 поправил в ГОСТ
    [DI.spl7]
